maciejgaik/Inverted_pendulum/Latex/main.tex

%\documentclass[printmode,oneside,eng]{mgr}  % do publikacji elektronicznej
\documentclass[oneside,printmode,eng]{mgr}  % do wydruku dwustronnego
%\documentclass[printmode,eng,draft]{mgr}  % do wydruku dwustronnego w~wersji roboczej

%----------------------| Input encoding configuration |

\usepackage[utf8]{inputenc}

%-------------------------| Typeface configuration |------------------------

%% Najpierw (chyba) należy wybrać czcionkę tekstu, potem matematyki

%% wybór czcionki Computer Concrete specjalnie zaprojektowanej do użycia 
%% z~czcionką matematyczną euler (nie ma ona niestety wersji bold - proponuje się więc użycie bolda z kroju
%%   Computer Modern Sans Serif)
%\usepackage{beton}             % ZALECANA DO SKŁADU TEKSTÓW PO ANGIELSKU
%\renewcommand{\bfdefault}{sbc} % to use Computer Modern Sans Serif demibold condensed fonts as bold 
%% choć może komuś bardziej podobać się będzie ten krój normalnej szerokości
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
  \begin{minipage}{\linewidth-2\fboxsep}}
 {\end{minipage}%
  \end{lrbox}%
  \setlength{\topsep}{\bigskipamount}% set the vertical space
  \trivlist\item\relax % ensure going to a new line
  \colorbox{\minted@bgcol}{\usebox{\minted@bgbox}}%
  \endtrivlist % close the trivlist
 }
\makeatother

%%pakiet do robienia notatek w trakcie pracy
\usepackage{todonotes}
\makeatletter   %spolszczenie
\renewcommand{\@todonotes@todolistname}{Do zrobienia}
\renewcommand{\@todonotes@MissingFigureText}{Rysunek}
\renewcommand{\@todonotes@MissingFigureUp}{Brakujący}
\renewcommand{\@todonotes@MissingFigureDown}{rysunek}
\makeatother

%% dodaje w pliku wynikowym klucze etykiet i referencji - wygodne przy pracy nad tekstem
%\usepackage{showkeys}

%%inne przydatne
%\usepackage{fancyhdr}
%\usepackage{fancyvrb}
%\usepackage{lipsum}  
%\usepackage{listings}

%-----------------------| End of packetology |----------------------

%---------------------------| Tytularia |---------------------------

% Zmień dane stosownie do tytułu i autora pracy tutaj
% ALE TEŻ I W POLECENIU \pdftitle NIECO PONIŻEJ! (Hyper data general configuration)
\author{Maciej Gaik}
\title{Projekt budowy odwróconego wahadła matematycznego}
\engtitle{Design and construction reversed pendulum}
\supervisor{Dr inż. Mateusz Cholewiński,\\ Katedra Cybernetyki i~Robotyki}
\field{Automatyka i~Robotyka (AIR)}
\specialisation{Robotyka (ARR)}
\date{2020}

%-------------------------| Hyper data general configuration |------------------------

\hypersetup{unicode,
   pdfpagemode=UseOutlines,   % otwiera dokument w trybie jednej strony
   pdfpagelayout=SinglePage,  %
   pdfstartpage=1,            % na podanej stronie
   bookmarksopen=true,        % rozwinięcie zakładek
   bookmarksopenlevel=1,      % do jakiego poziomu
   colorlinks=true,      % kolorowanie odnośników zamiast ramki wokół nich
   citecolor=cyan,       % kolor odnośników do bibliografii, domyślnie zielony
   filecolor=red,        % kolor odnośników do lokalnych plików, domyśnie magenta
   linkcolor=blue,       % kolor odnośników wewnętrznych, domyślnie czerwony
   menucolor=green,      % kolor pozycji menu Acrobata, domyślnie czerwony
   urlcolor=blue,        % kolor odnośników do adresów internetowych, domyślnie cyan
                              % DANE DOKUMENTACJI
   pdftitle={Bąk jaki jest każdy widzi. Studium zachowań - Przykład
    i~wytyczne formatowania pracy dyplomowej},
   pdfauthor={Roberto Orozco, Robert Muszyński},
   pdfsubject={Praca dyplomowa inżynierska - przykład i~wytyczne},
   pdfkeywords={bąk, Lagrange top, Euler top, praca dyplomowa, formatowanie, wytyczne}
}

%-------------------------| Geometria strony |-----------------------------

\geometry{
    top = 25mm,
    headheight = 15mm,
    headsep = 3mm,
    textheight = 24cm,
    textwidth = 16cm,
}

%---------------------| Frequently used commands definitions |-------------------

\newcommand{\red}{\color{red}}
\def\BibTeX{{\rm B\kern-.05em{\sc i\kern-.025em b}\kern-.08em
    T\kern-.1667em\lower.7ex\hbox{E}\kern-.125emX}}

\newtheorem{uwaga}{Uwaga}
\newtheorem{twr}{Twierdzenie}
%------------------------------------| END |-------------------------------------

%----------------------------| Math symbols definition |-------------------------

\newcommand{\angmom}{\boldsymbol{m}}
\newcommand{\bdvelo}{\boldsymbol{\omega}_B}
\newcommand{\grav}{\boldsymbol{g}}
\newcommand{\lagran}{L(\boldsymbol{q},\boldsymbol{\dot{q}})}
\newcommand{\COMvec}{\boldsymbol{r}_B}
\newcommand{\ee}{\boldsymbol{e}}
\newcommand{\FF}{\boldsymbol{F}}
\newcommand{\xx}{\boldsymbol{x}}
\newcommand{\qq}{\boldsymbol{q}}
\newcommand{\RR}{\boldsymbol{R}}
\newcommand{\TT}{\boldsymbol{T}}
\newcommand{\pp}{\boldsymbol{p}}
\newcommand{\iner}{\boldsymbol{I}_B}
\newcommand{\vv}{\boldsymbol{v}}
\newcommand{\bbs}{\boldsymbol}
\DeclareMathOperator{\const}{const}
\DeclareMathOperator*{\rank}{rank} 

\graphicspath{{figures/chapter_01/}{figures/chapter_02/}{figures/chapter_03/}{figures/chapter_04/}}

\begin{document}

\pdfbookmark{Strona tytułowa}{tytul}
\maketitle
%% informacja o sposobie udostępniania tego dokumentu
%\input{sources/copyleft.tex}

\cleardoublepage
\pdfbookmark{\contentsname}{Contents}
\tableofcontents            %spis treści
\markboth{\contentsname}{\contentsname}
%\input{sources/notka}       %notka o systemie składu i czcionkach
%\input{sources/font-note}   %przykładowa wersja angielska notki

%% część właściwa dokumentu
\include{praca_dyplomowa/sources/00_Wstep}
\include{praca_dyplomowa/sources/01_wprowadzenie_matematyczne}
\include{praca_dyplomowa/sources/02_symulacja}
\include{praca_dyplomowa/sources/03_konstrukcja}
\include{praca_dyplomowa/sources/04_elektronika}
\include{praca_dyplomowa/sources/05_oprogramowanie}
\include{praca_dyplomowa/sources/06_sterowanie}
\include{praca_dyplomowa/sources/50_zakonczenie}

\cleardoublepage
\phantomsection
\addcontentsline{toc}{chapter}{\bibname}
\bibliographystyle{alphapl}
\bibliography{sources/bibliografia}
\markboth{\bibname}{\bibname}

%%spis rysunków
\cleardoublepage
\phantomsection
\addcontentsline{toc}{chapter}{\listfigurename}
\listoffigures
\markboth{\listfigurename}{\listfigurename}

\appendix
\include{sources/90_dodatek_a}

\end{document}
