maciejgaik/Inverted_pendulum/Latex/sources/90_dodatek_a.tex

%\chapter{Skrypt symulacji}
\begin{figure}[tp]
    \centering
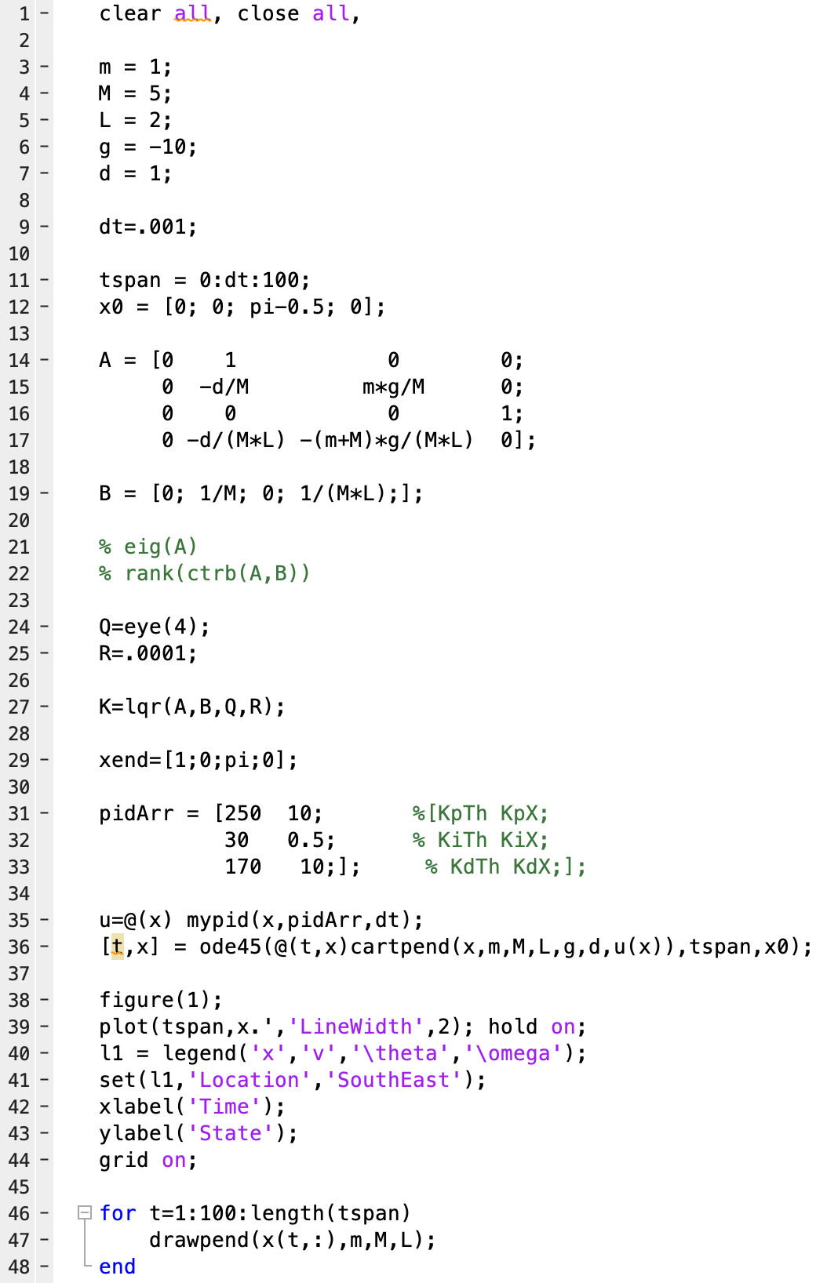
[picture p19: Latex/figures/simpend.png]
    
    \caption{Główny skrypt symulacji}
    \label{fig:simpend}
\end{figure}

\begin{figure}
    \centering
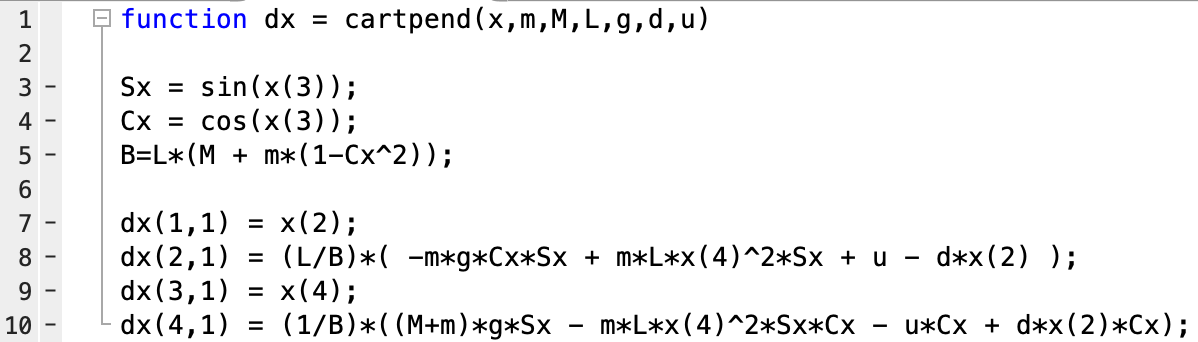
[picture p20: Latex/figures/cartpend.png]
    
    \caption{Funkcja \textit{cartpend}}
    \label{fig:cartpend}
\end{figure}

\begin{figure}
    \centering
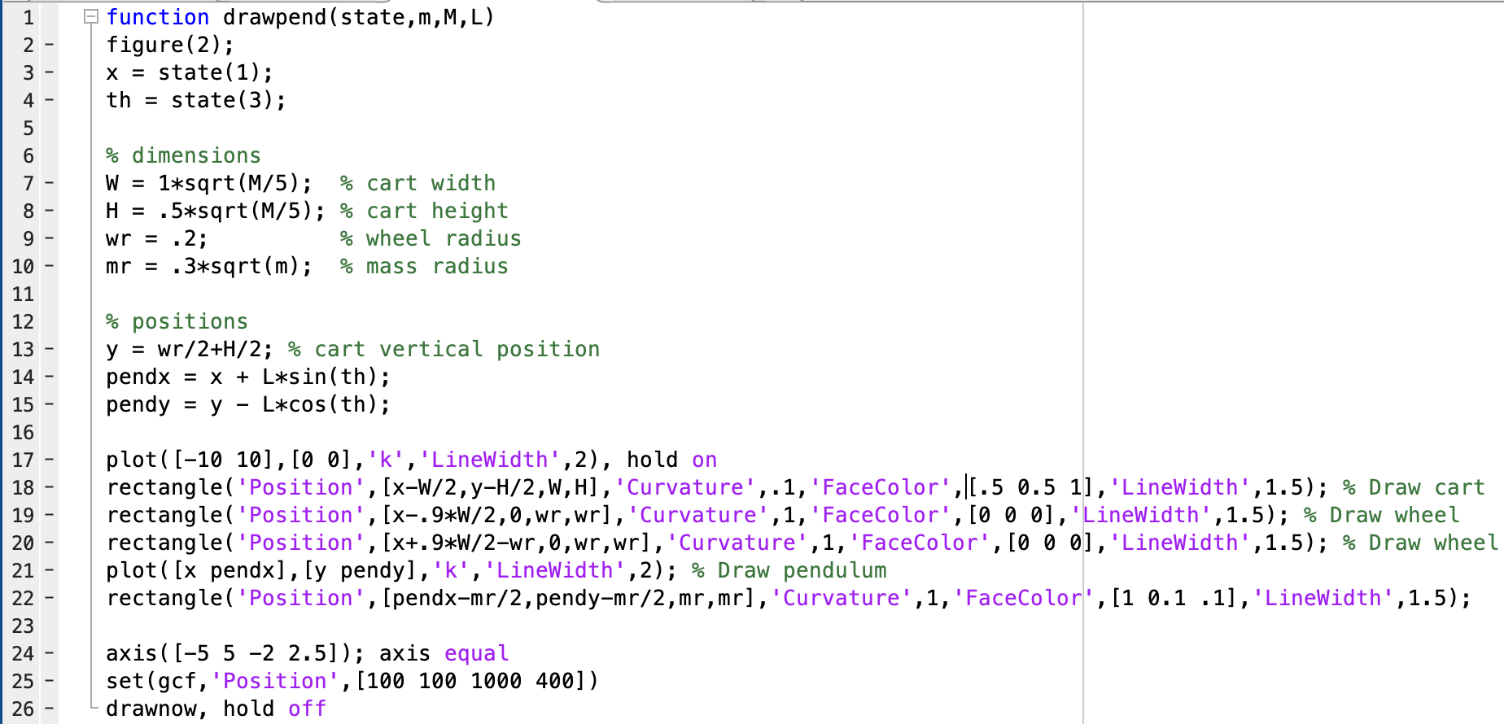
[picture p21: Latex/figures/drawpend.png]
    
    \caption{Funkcja \textit{drawpend}}
    \label{fig:drawpend}
\end{figure}

\begin{figure}
    \centering
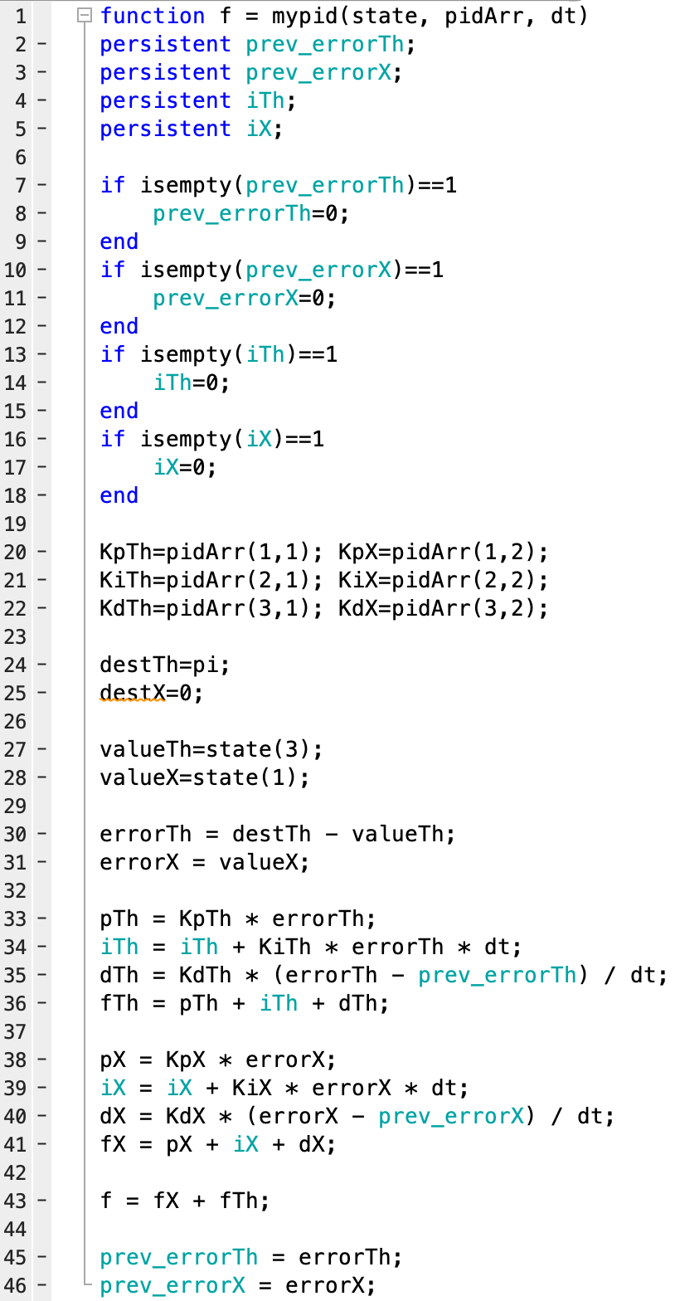
[picture p22: Latex/figures/mypid.png]
    
    \caption{Funkcja \textit{mypid}}
    \label{fig:mypid}
\end{figure}

%\chapter{Oprogramowanie}
\begin{figure}
    \centering
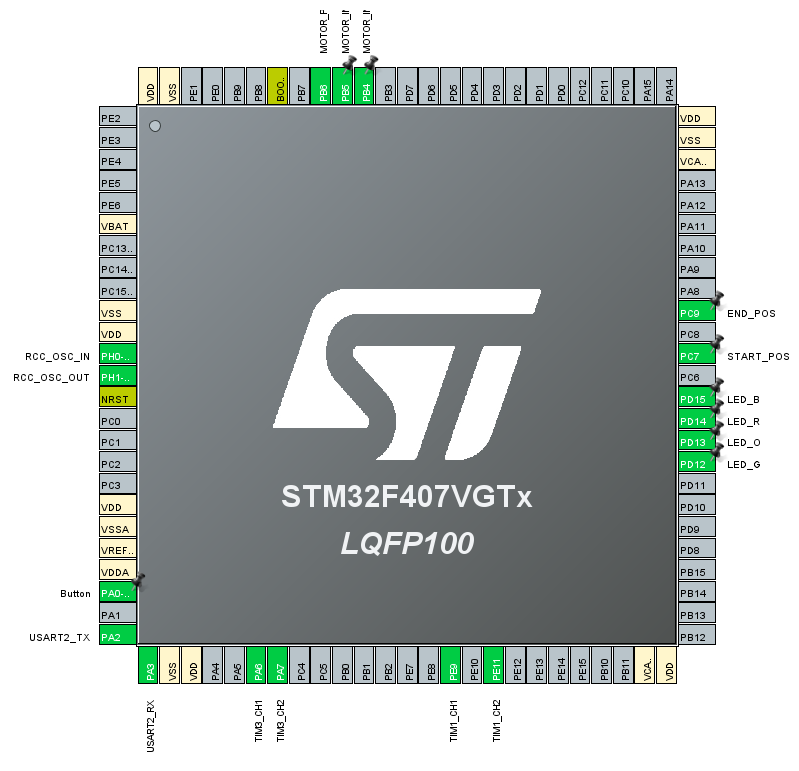
[picture p23: Latex/figures/stmConfig.png]
    
    \caption{Konfiguracja wejść/wyjść mikrokontrolera}
    \label{fig:stmconfig}
\end{figure}

\begin{figure}
    \centering
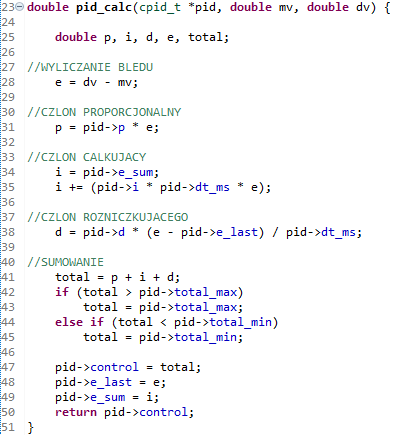
[picture p24: Latex/figures/pidkod.png]
    
    \caption{Algorytm regulatora \textit{PID IND}}
    \label{fig:pidind}
\end{figure}
