maciejgaik/Inverted_pendulum/Image/EnkderWah.png

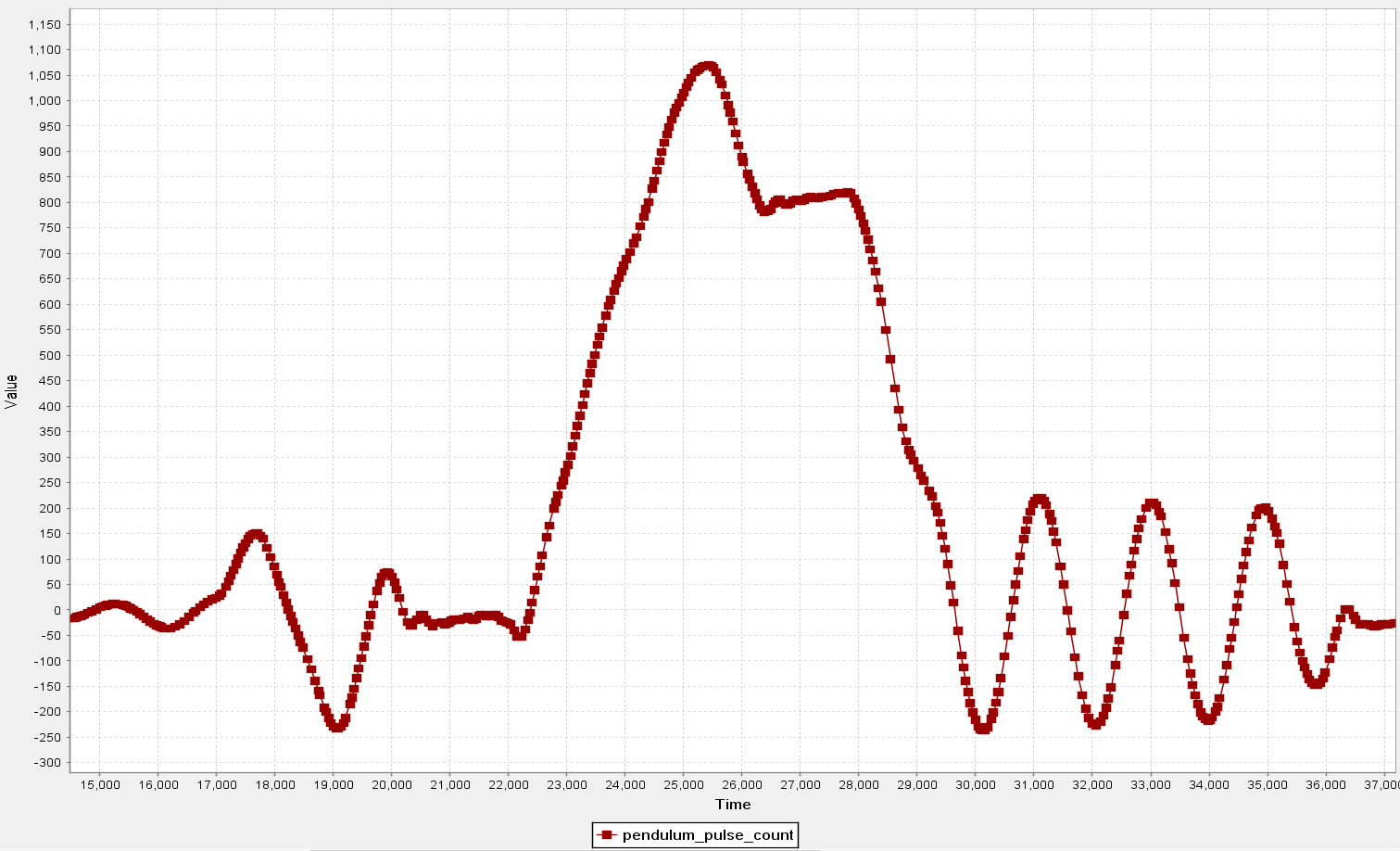
Image/EnkderWah.png
