maciejgaik/Inverted_pendulum/Image/IMG_20200908_130321.jpg

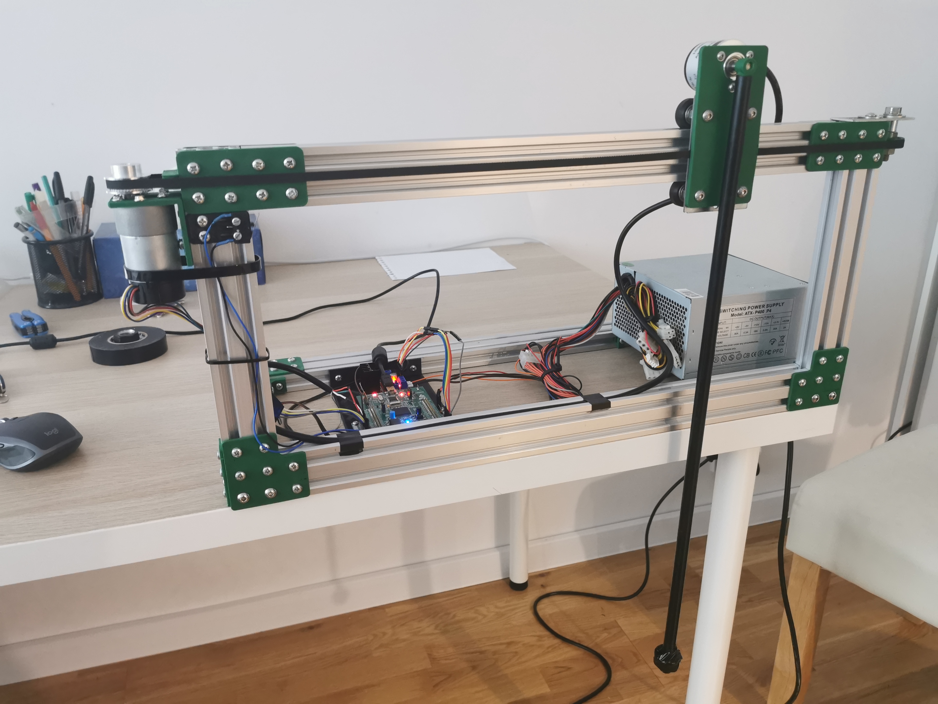
Image/IMG_20200908_130321.jpg
