maciejgaik/Inverted_pendulum/Image/IMG_20200908_130335.jpg

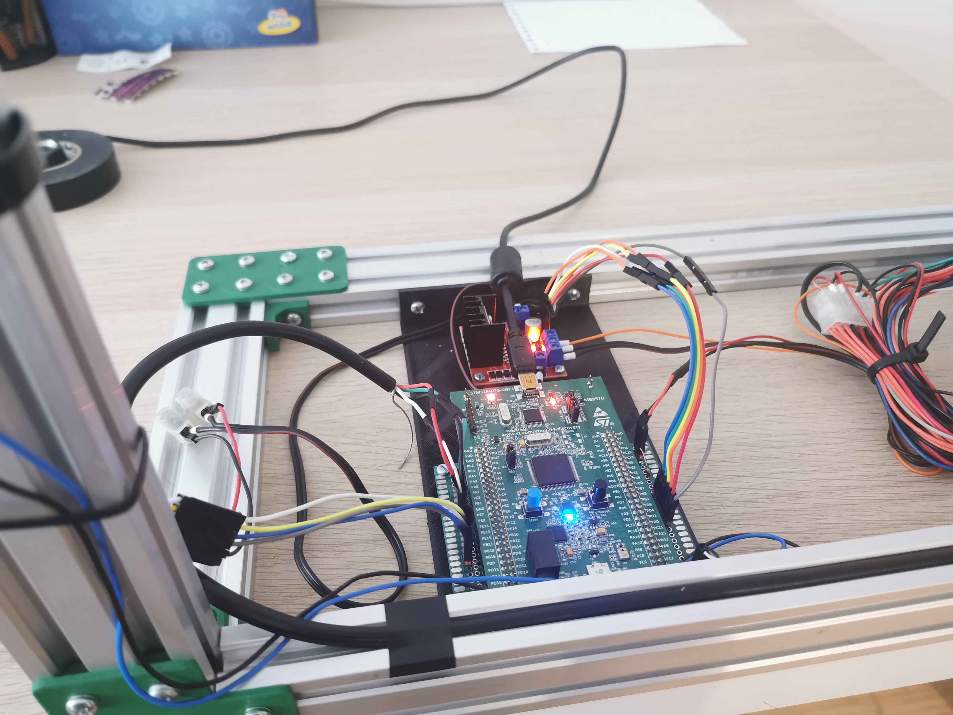
Image/IMG_20200908_130335.jpg
