maciejgaik/Inverted_pendulum/Image/IMG_20200908_130345.jpg

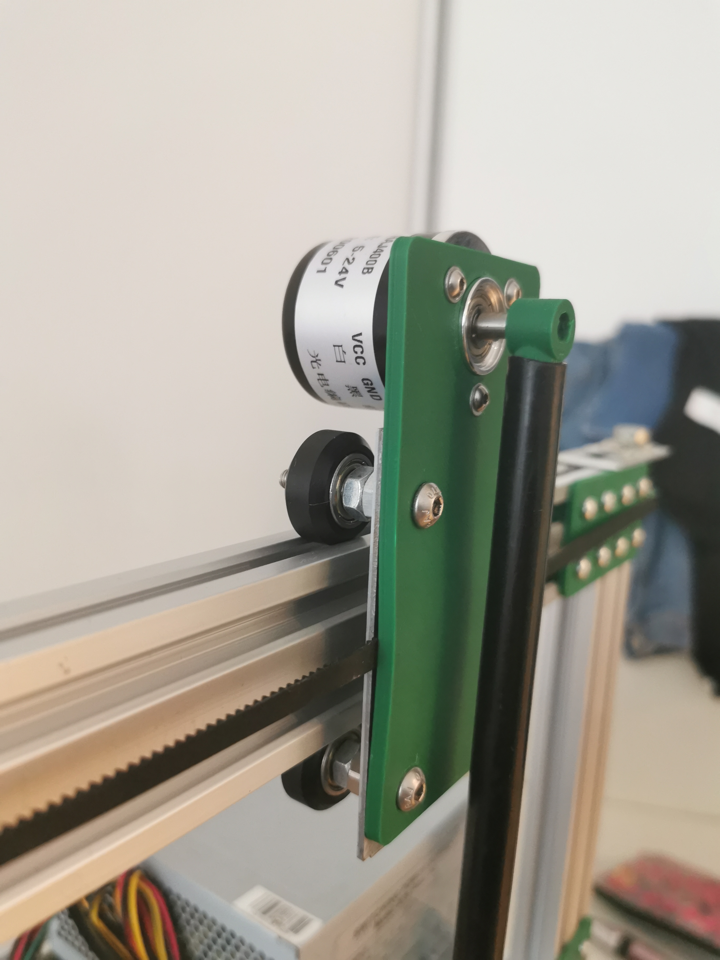
Image/IMG_20200908_130345.jpg
