maciejgaik/Inverted_pendulum/Image/pdmotor.png

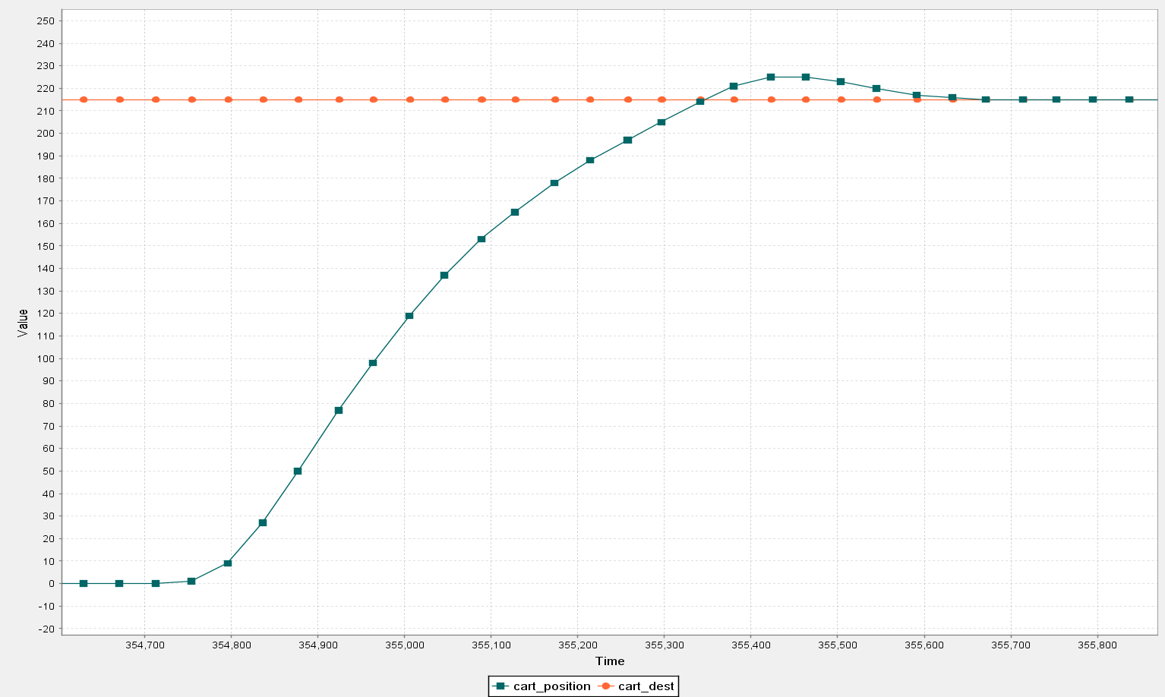
Image/pdmotor.png
