maciejgaik/Inverted_pendulum/Image/pendulum1.jpg

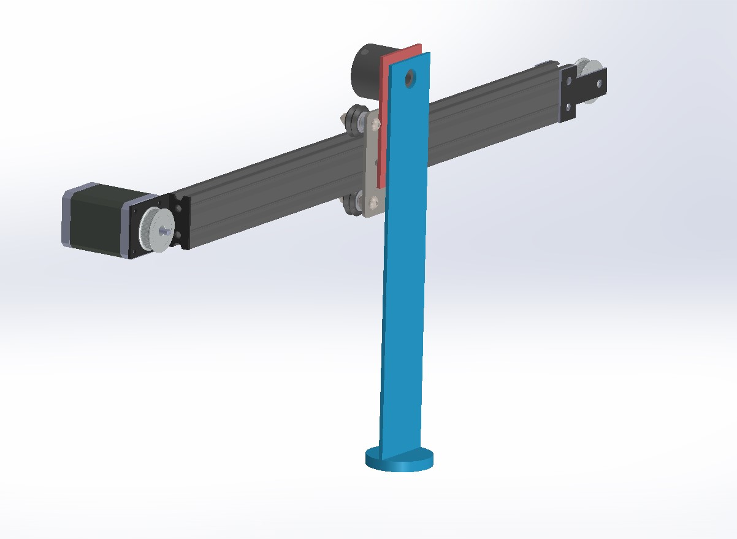
Image/pendulum1.jpg
