maciejgaik/Inverted_pendulum/Image/pendulum2.jpg

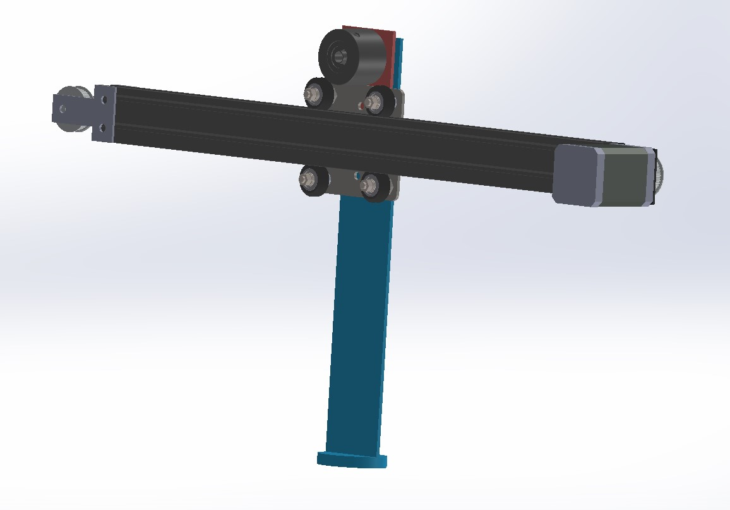
Image/pendulum2.jpg
