maciejgaik/Inverted_pendulum/Image/pendulum3.jpg

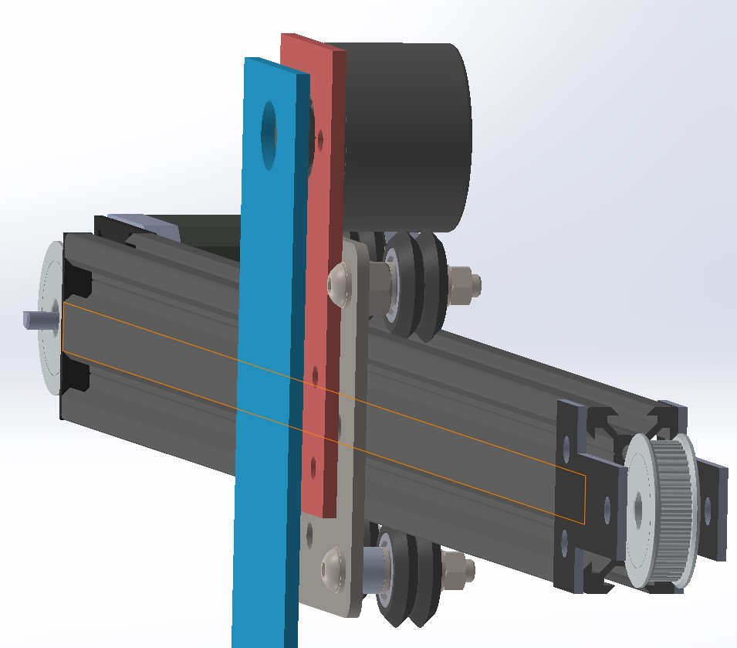
Image/pendulum3.jpg
