maciejgaik/Inverted_pendulum/Image/pendulum4.jpg

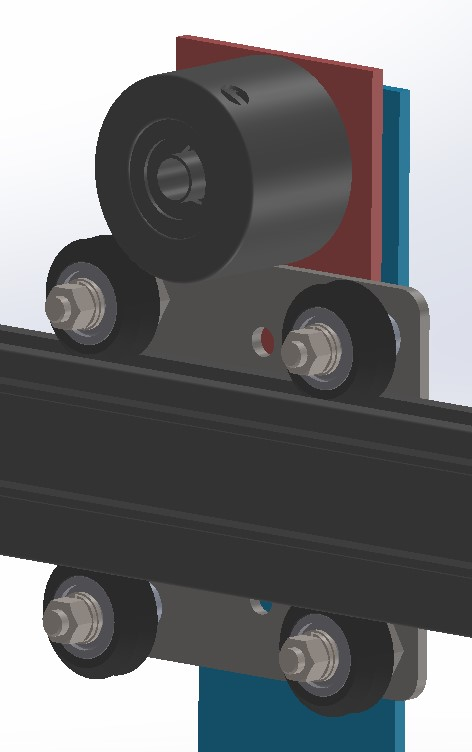
Image/pendulum4.jpg
