maciejgaik/Inverted_pendulum/Image/pendulum5.jpg

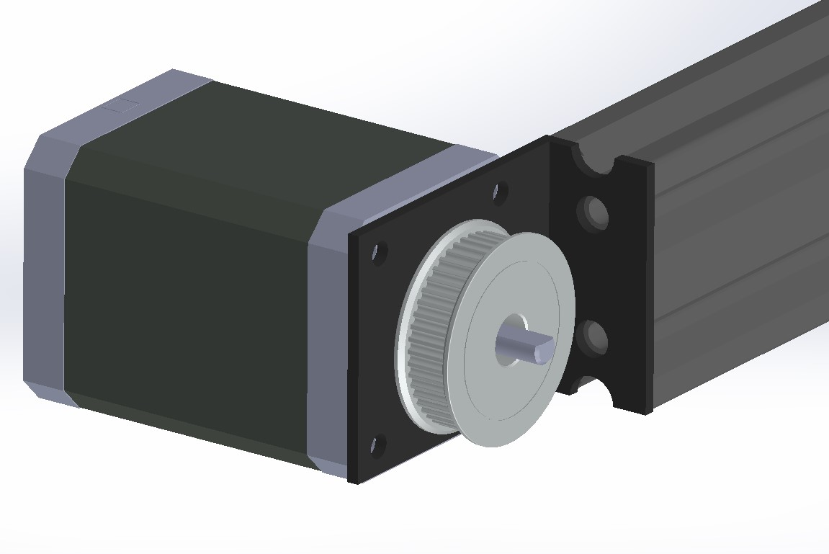
Image/pendulum5.jpg
