maciejgaik/Inverted_pendulum/Image/pendulum7.jpg

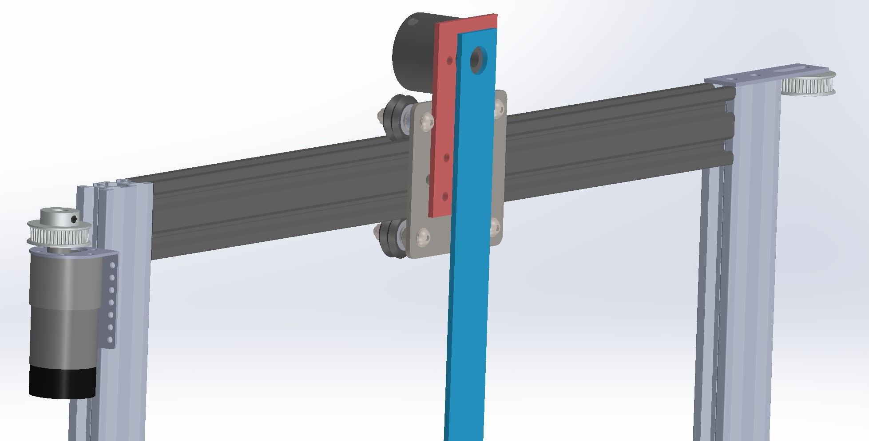
Image/pendulum7.jpg
