maciejgaik/Inverted_pendulum/Image/pidcontrol-alpha.png

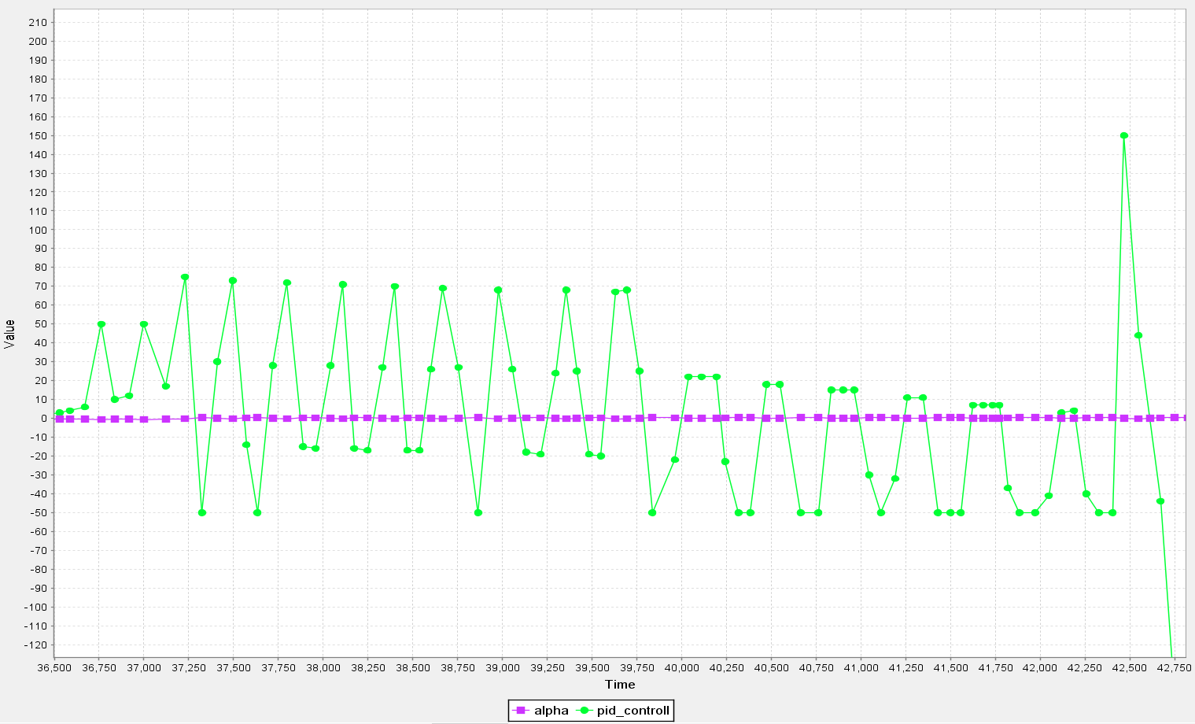
Image/pidcontrol-alpha.png
