maciejgaik/Inverted_pendulum/Image/pidpend.png

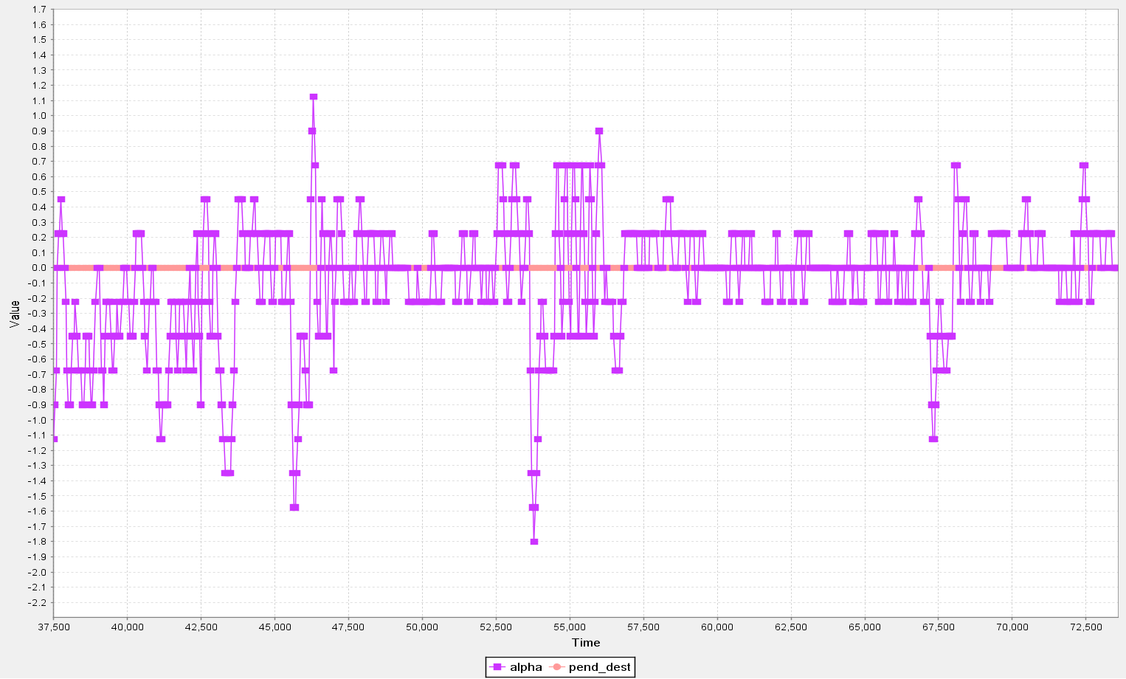
Image/pidpend.png
