maciejgaik/Inverted_pendulum/Latex/figures/EnkderWah.png

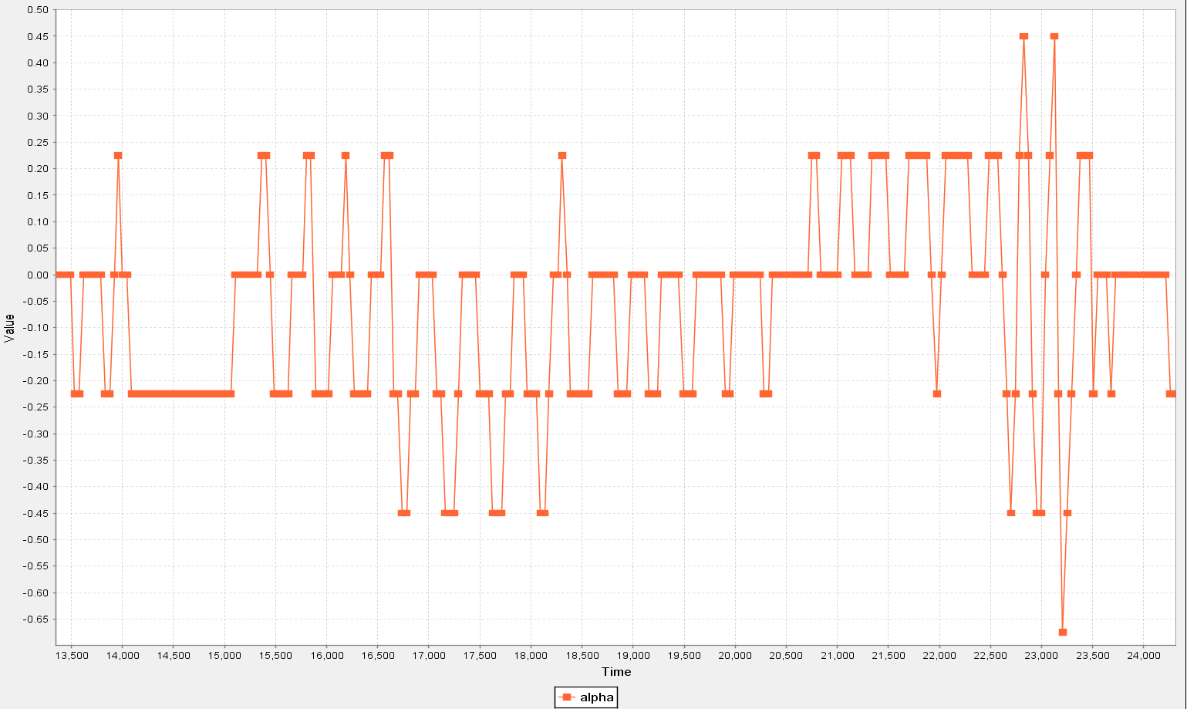
Latex/figures/EnkderWah.png
