maciejgaik/Inverted_pendulum/Latex/figures/EnkoderMot.png

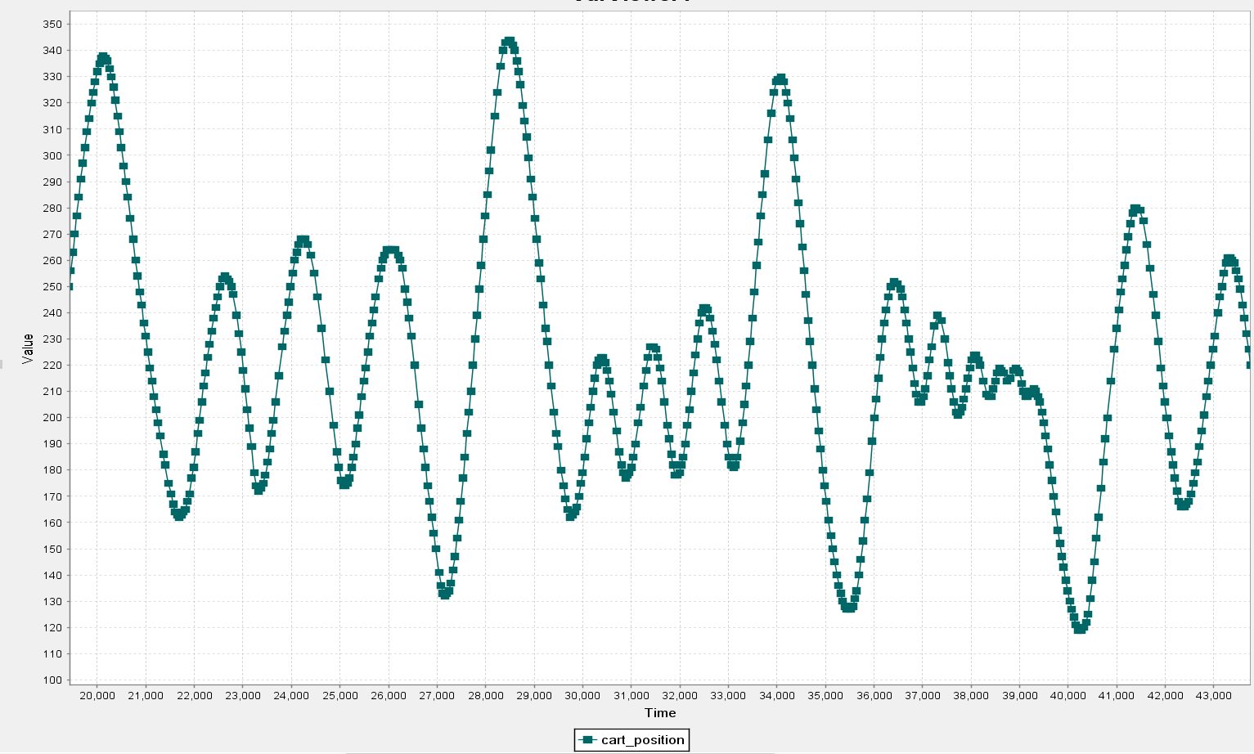
Latex/figures/EnkoderMot.png
