maciejgaik/Inverted_pendulum/Latex/figures/pendulum6.jpg

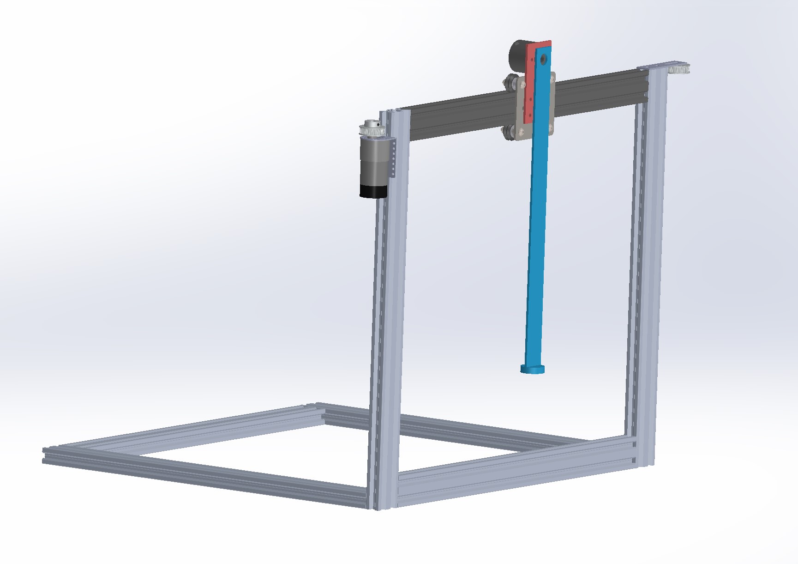
Latex/figures/pendulum6.jpg
