maciejgaik/Inverted_pendulum/Latex/figures/rpidisplay2.jpg

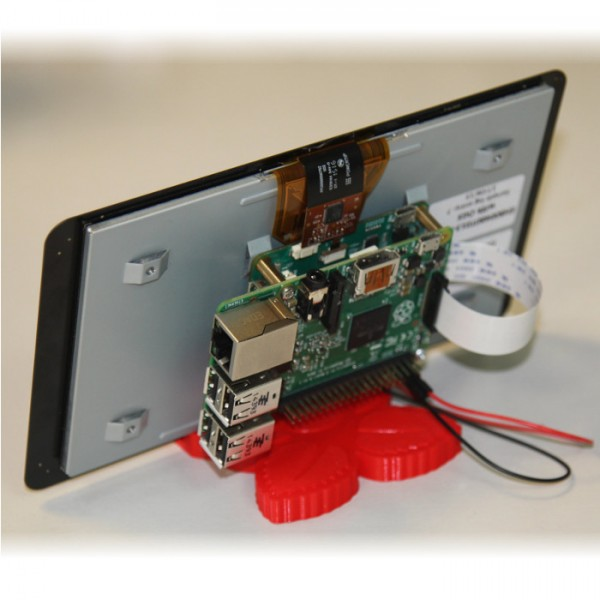
Latex/figures/rpidisplay2.jpg
