maciejgaik/Inverted_pendulum/Latex/figures/WykresEnkoder.png

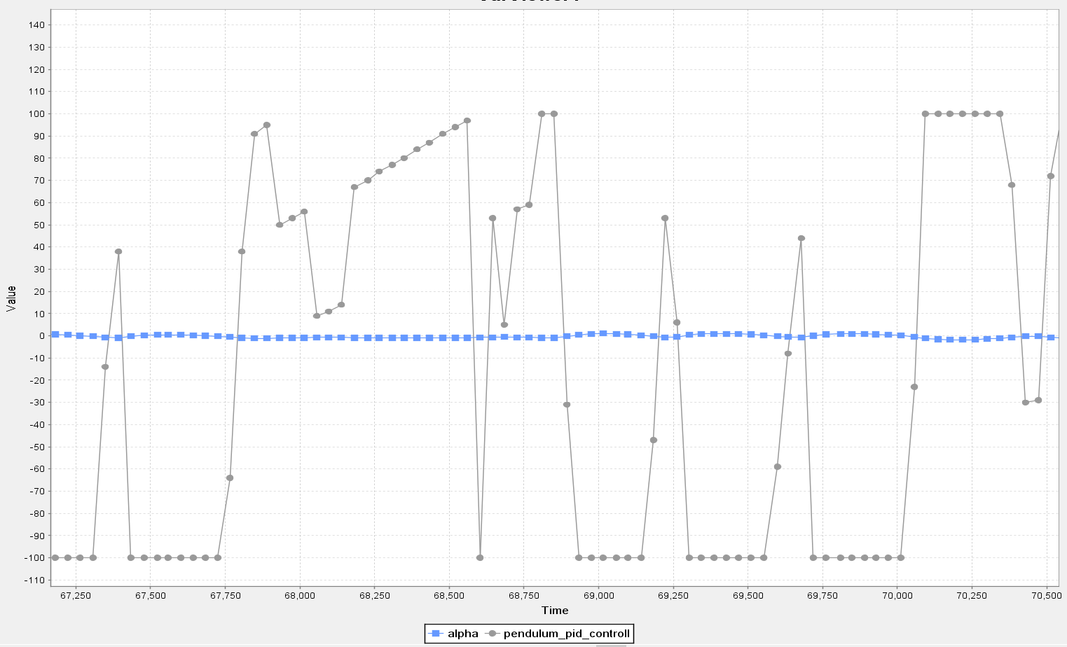
Latex/figures/WykresEnkoder.png
