maciejgaik/Inverted_pendulum/Latex/figures/WykresMain.png

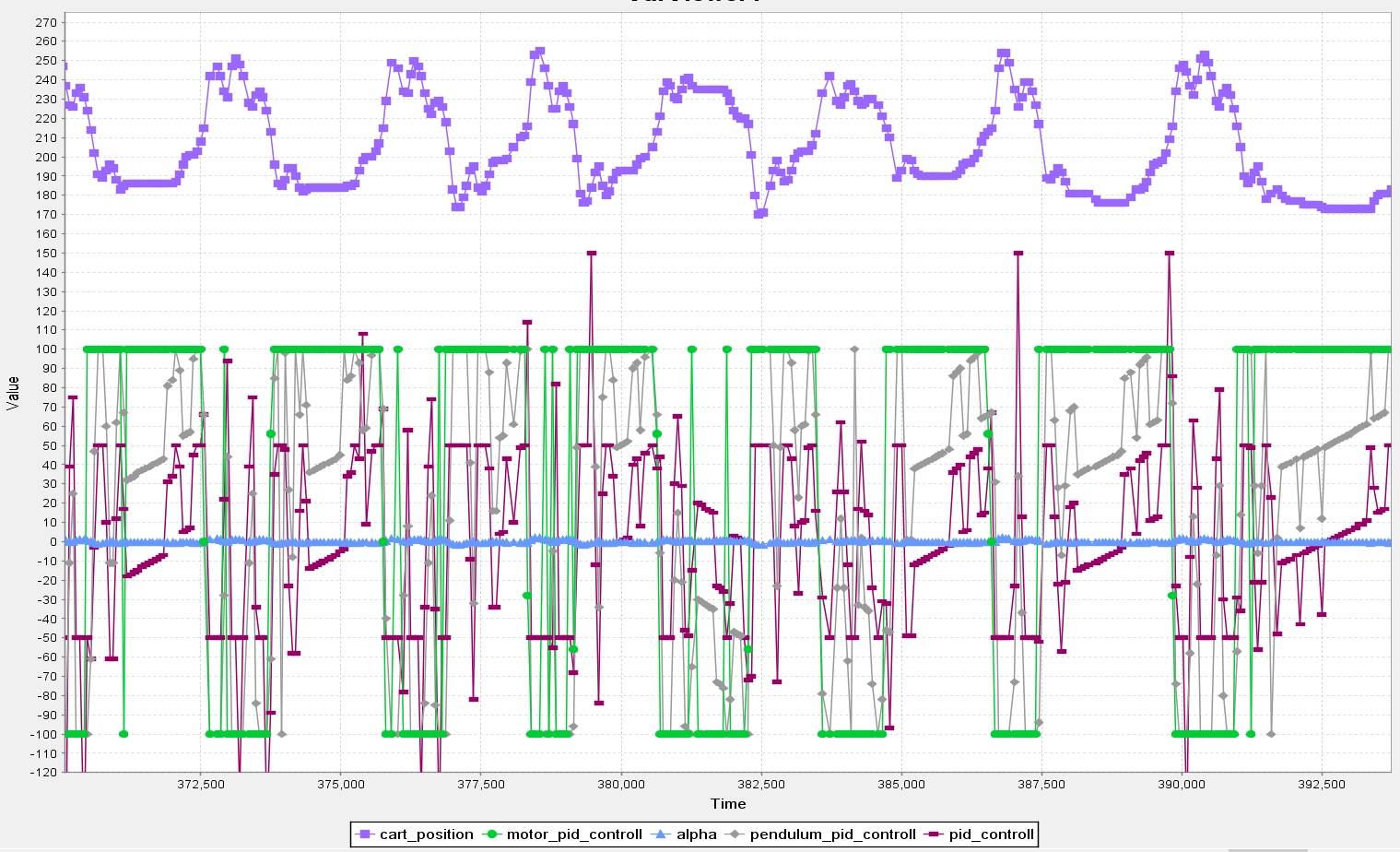
Latex/figures/WykresMain.png
