maciejgaik/Inverted_pendulum/Latex/figures/WykresMotor.png

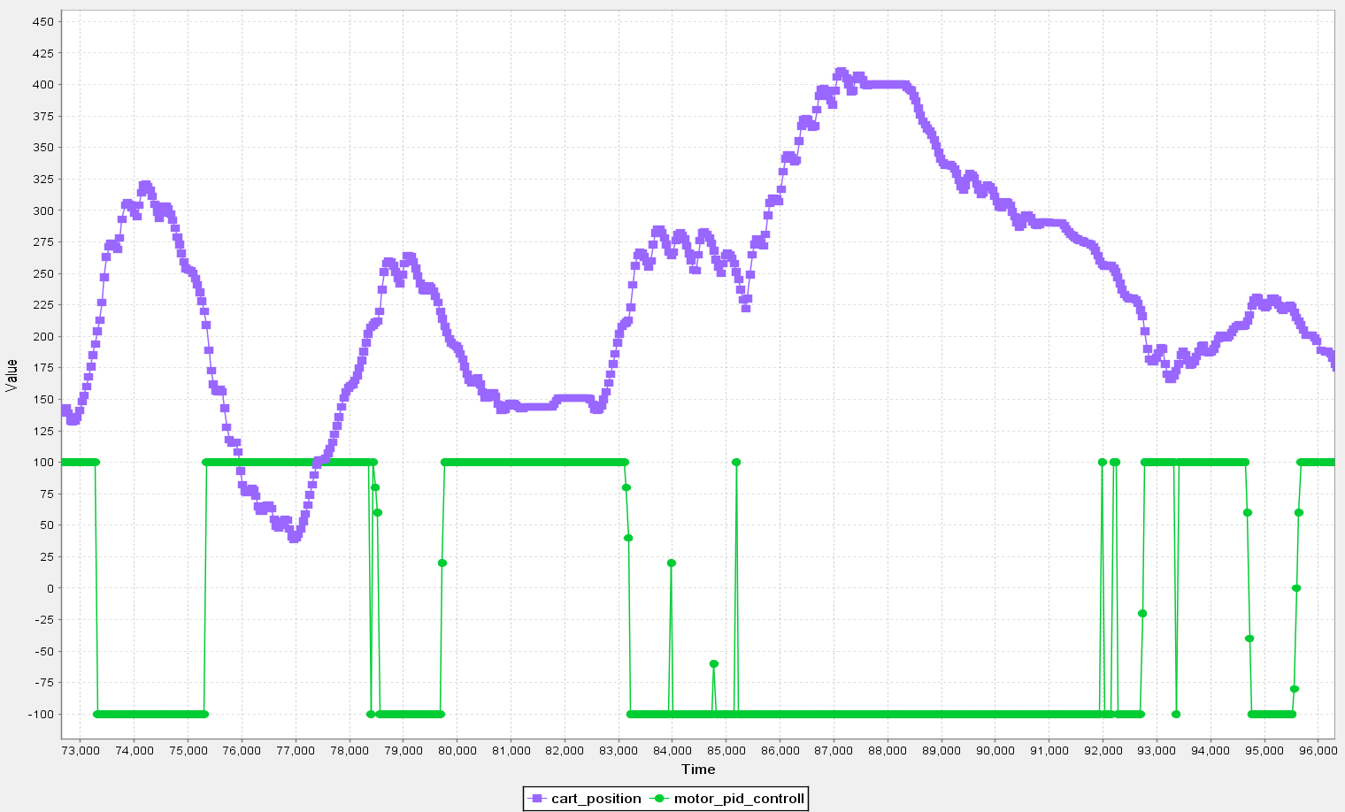
Latex/figures/WykresMotor.png
