maciejgaik/Inverted_pendulum/Assembling/Złożenie3.SLDASM

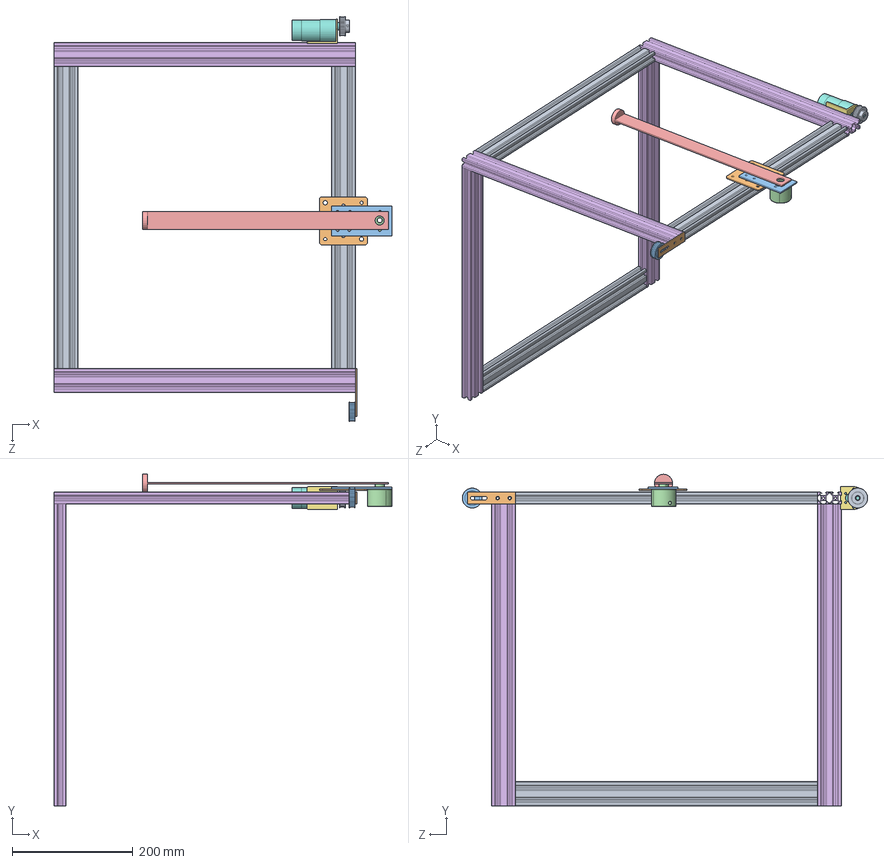
[picture p47: CAD file, 2020-08-21]
Assembling/Złożenie3.SLDASM
560.2 x 549.6 x 671.9 mm
profil 2040 500 x 3
Kit CGV02-05 + EEV01-01 + RWV01-01
bracket
Encoder tanso H40
pendulum
profil 2040 250 x 4
Pololu Stamped Aluminum L-Bracket Pair for 37D mm Metal Gearmotors
Gearmotor_37D_100.stp
GT2_48T_8_6
idle bracket
GT2_48T_8_6 idle
