maciejgaik/Inverted_pendulum/Assembling/Encoder Bracket.SLDPRT

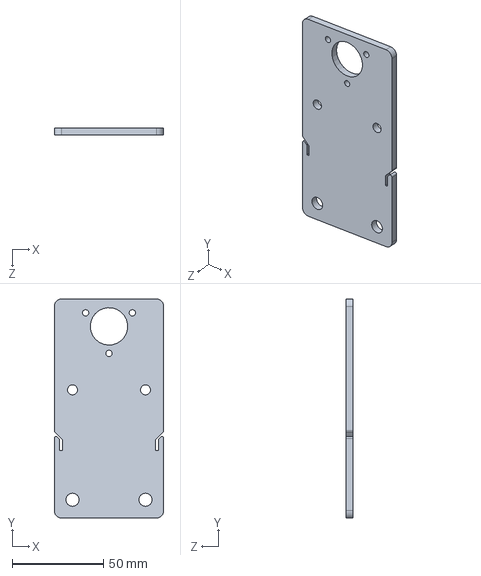
[picture p48: CAD file, 2020-09-28]
Assembling/Encoder Bracket.SLDPRT
60.0 x 120.0 x 4.00 mm
