maciejgaik/Inverted_pendulum/Assembling/krancowka2.SLDPRT

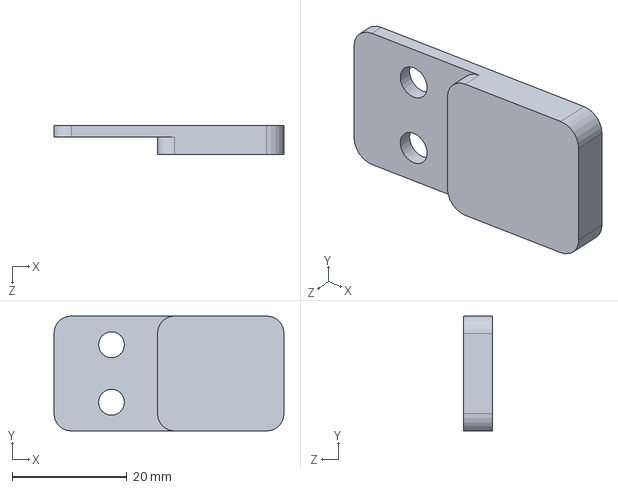
[picture p49: CAD file, 2020-09-01]
Assembling/krancowka2.SLDPRT
40.0 x 20.0 x 5.00 mm
