maciejgaik/Inverted_pendulum/Assembling/krancowka.SLDPRT

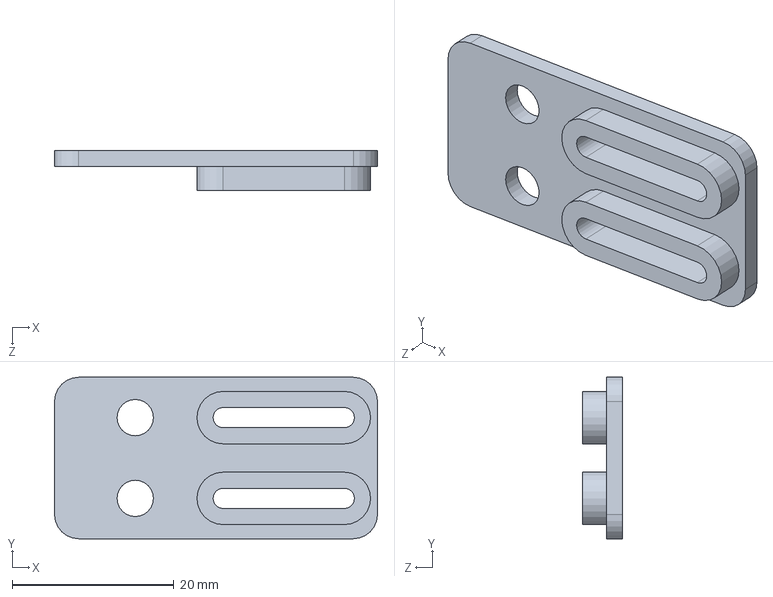
[picture p50: CAD file, 2020-09-01]
Assembling/krancowka.SLDPRT
40.0 x 20.0 x 5.00 mm
