maciejgaik/Inverted_pendulum/Assembling/stm bracket.STL

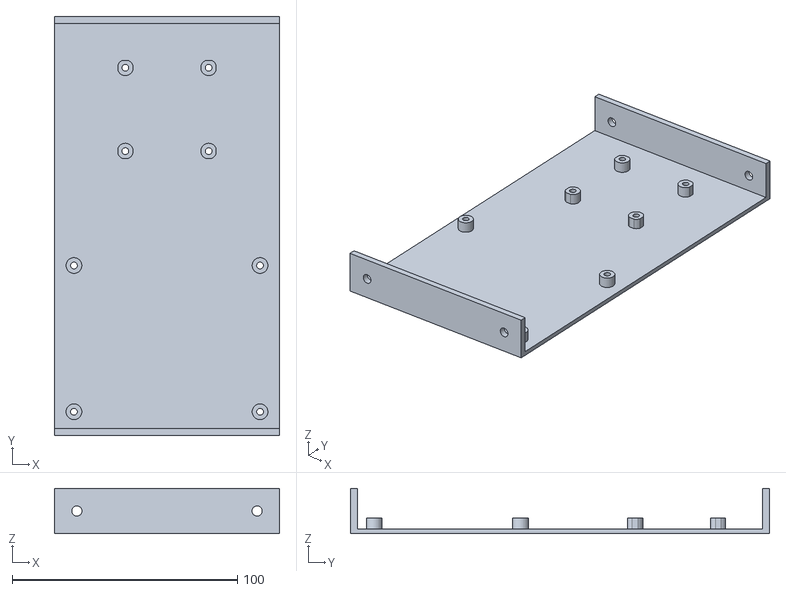
[picture p51: CAD file, 2020-08-29]
Assembling/stm bracket.STL
100.0 x 186.0 x 20.0
