maciejgaik/Inverted_pendulum/Assembling/power supply stand.SLDPRT

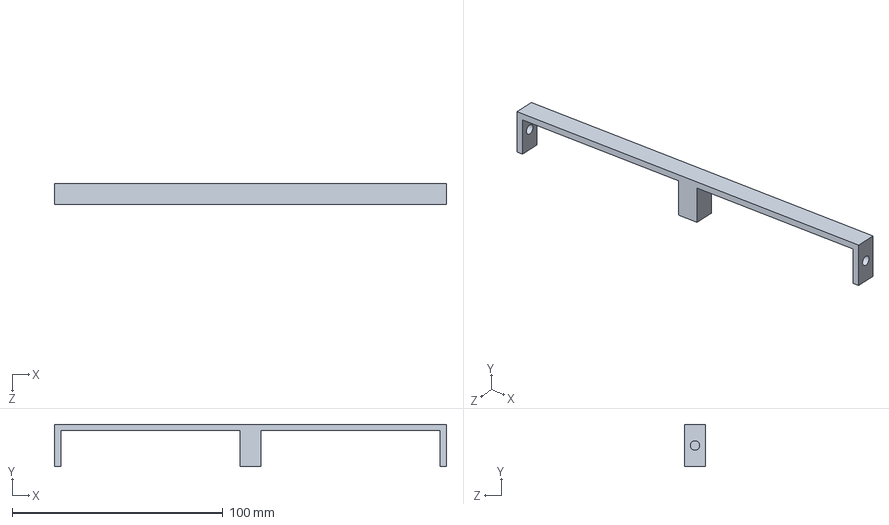
[picture p52: CAD file, 2020-08-27]
Assembling/power supply stand.SLDPRT
186.0 x 20.0 x 10.0 mm
