maciejgaik/Inverted_pendulum/Assembling/power supply bracket.SLDPRT

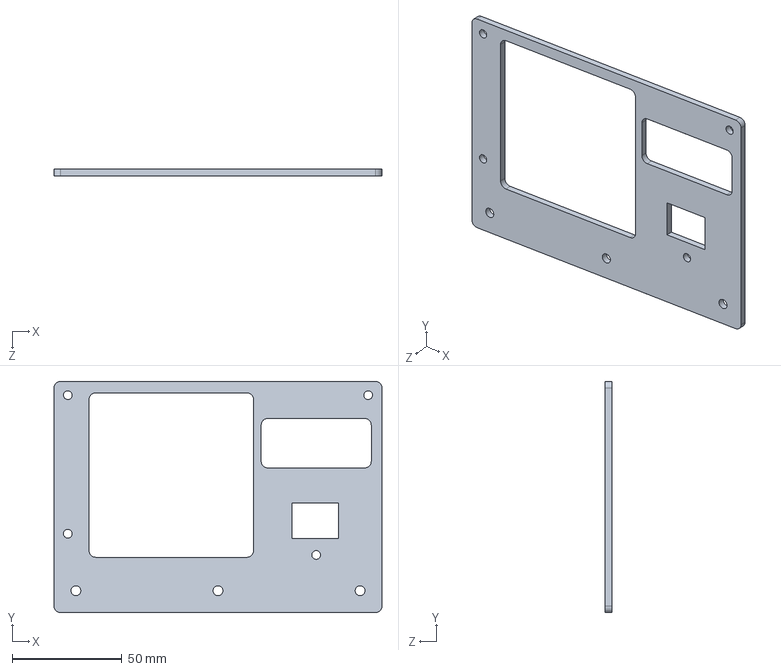
[picture p53: CAD file, 2020-08-27]
Assembling/power supply bracket.SLDPRT
149.6 x 105.5 x 3.00 mm
