maciejgaik/Inverted_pendulum/Assembling/pololu bracket.STL

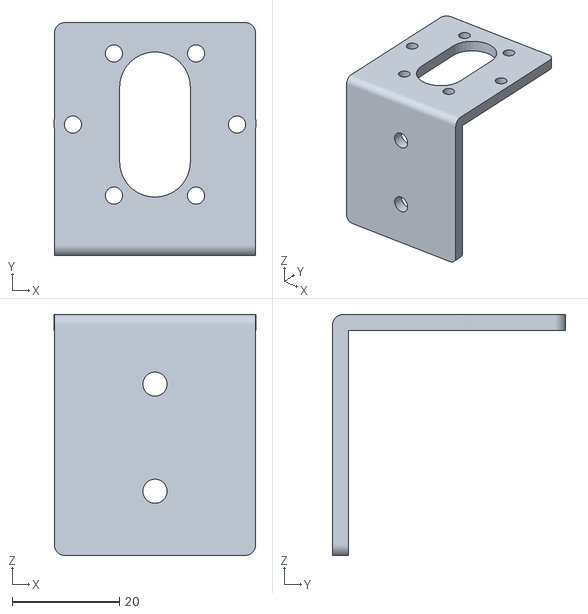
[picture p54: CAD file, 2020-08-27]
Assembling/pololu bracket.STL
37.7 x 43.5 x 45.0
