maciejgaik/Inverted_pendulum/Assembling/Pololu Stamped Aluminum L-Bracket Pair for 37D mm Metal Gearmotors.SLDPRT

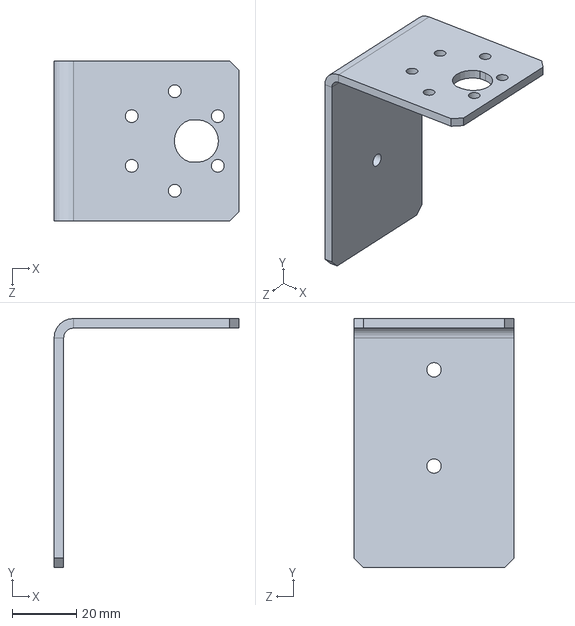
[picture p55: CAD file, 2020-08-27]
Assembling/Pololu Stamped Aluminum L-Bracket Pair for 37D mm Metal Gearmotors.SLDPRT
57.6 x 77.6 x 50.0 mm
