maciejgaik/Inverted_pendulum/Assembling/Kit CGV02-05 + EEV01-01 + RWV01-01.SLDPRT

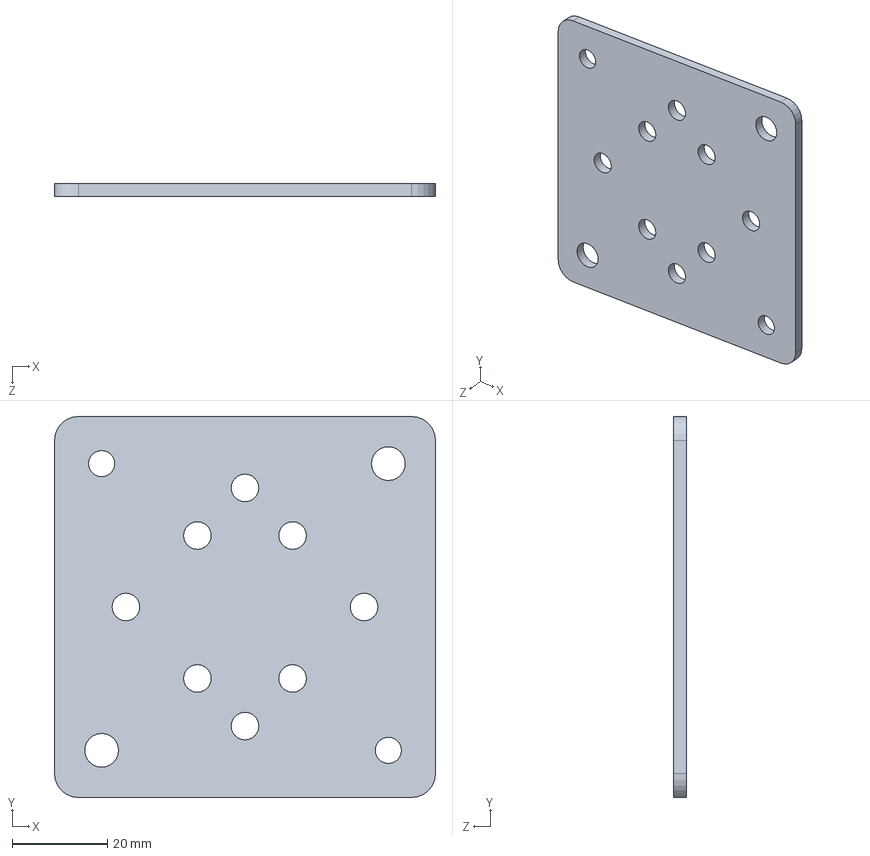
[picture p56: CAD file, 2020-08-21]
Assembling/Kit CGV02-05 + EEV01-01 + RWV01-01.SLDPRT
80.0 x 80.0 x 2.65 mm
