maciejgaik/Inverted_pendulum/Assembling/3x3 L Bracket.SLDPRT

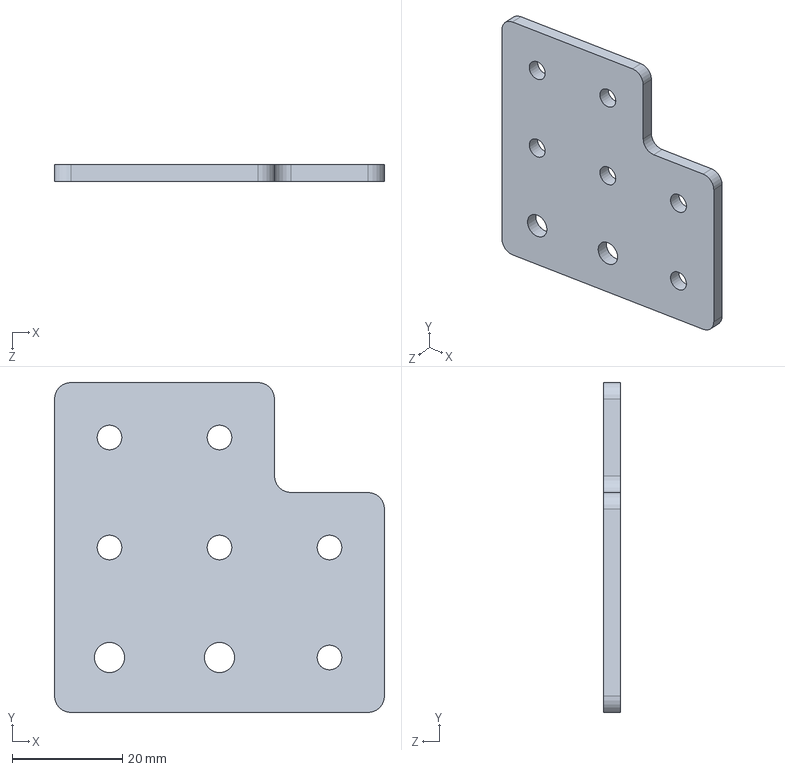
[picture p57: CAD file, 2020-08-19]
Assembling/3x3 L Bracket.SLDPRT
60.0 x 60.0 x 3.00 mm
