maciejgaik/Inverted_pendulum/Assembling/2x4_bracket.SLDPRT

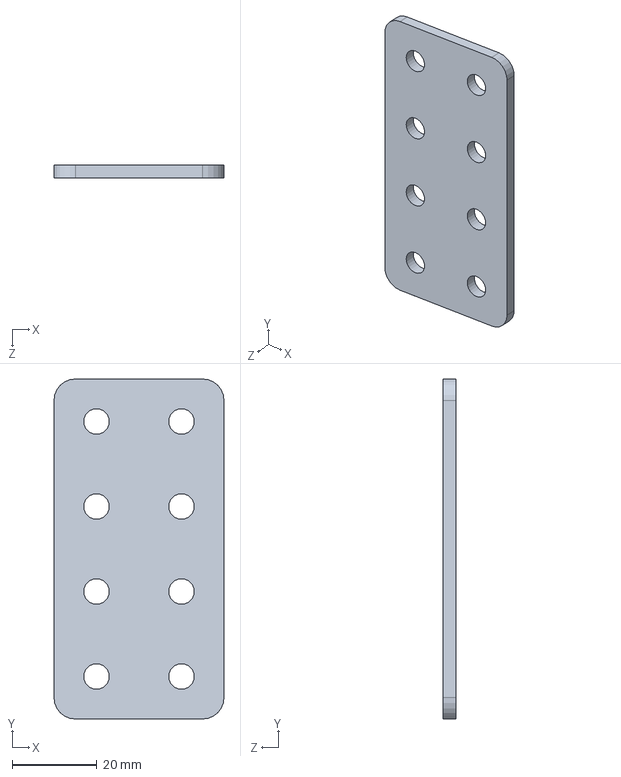
[picture p58: CAD file, 2020-08-17]
Assembling/2x4_bracket.SLDPRT
40.0 x 80.0 x 3.00 mm
