maciejgaik/Inverted_pendulum/Assembling/GT2_48T_8_6 idle.SLDPRT

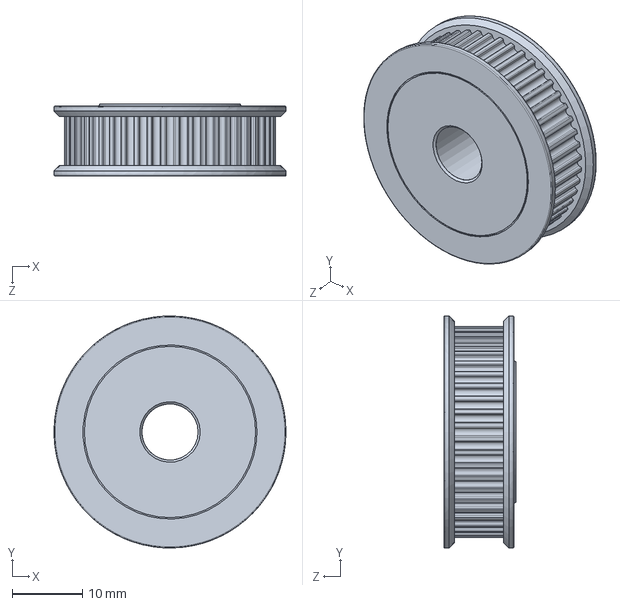
[picture p59: CAD file, 2020-08-15]
Assembling/GT2_48T_8_6 idle.SLDPRT
33.0 x 33.0 x 10.3 mm
