maciejgaik/Inverted_pendulum/Assembling/idle bracket.SLDPRT

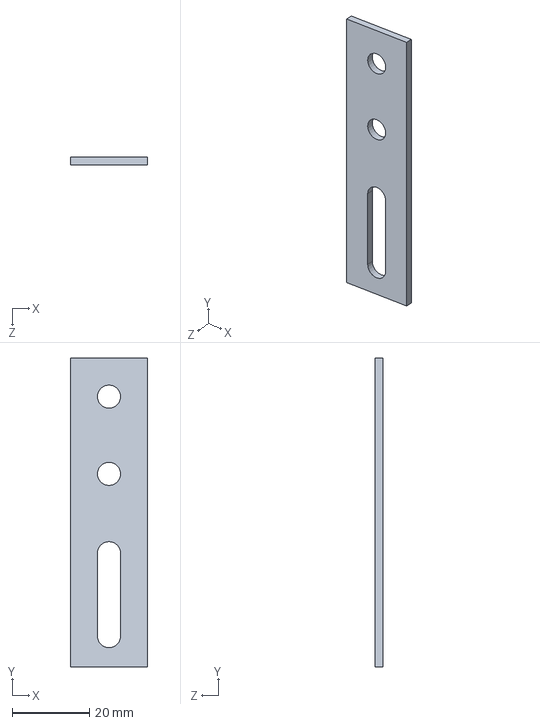
[picture p60: CAD file, 2020-08-15]
Assembling/idle bracket.SLDPRT
20.0 x 80.0 x 2.00 mm
