maciejgaik/Inverted_pendulum/Assembling/bracket.SLDPRT

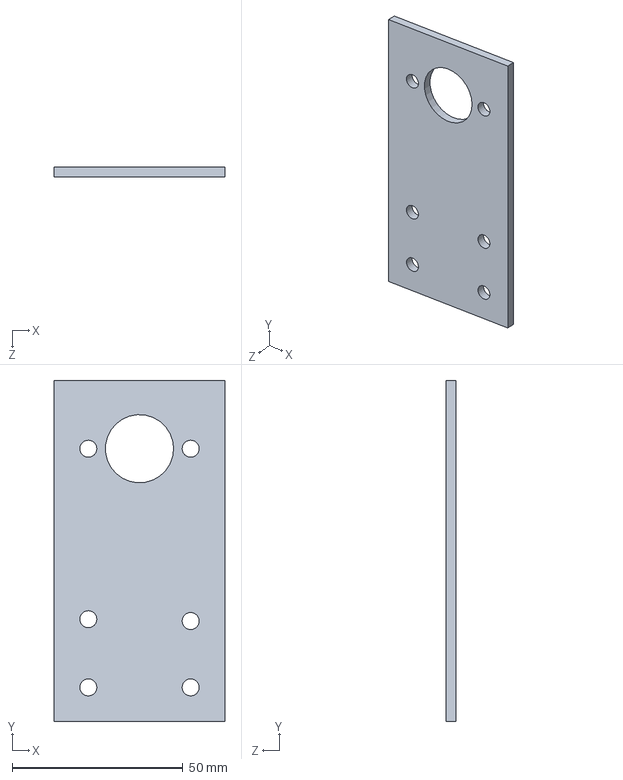
[picture p61: CAD file, 2020-08-15]
Assembling/bracket.SLDPRT
50.0 x 100.0 x 3.00 mm
