maciejgaik/Inverted_pendulum/Assembling/profil 2040 500.SLDPRT

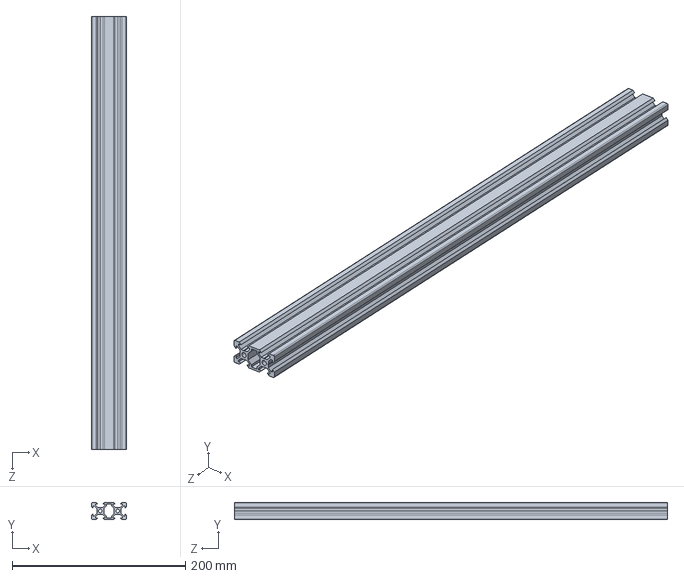
[picture p62: CAD file, 2020-08-15]
Assembling/profil 2040 500.SLDPRT
40.0 x 20.0 x 500.0 mm
