maciejgaik/Inverted_pendulum/Assembling/pendulum.SLDPRT

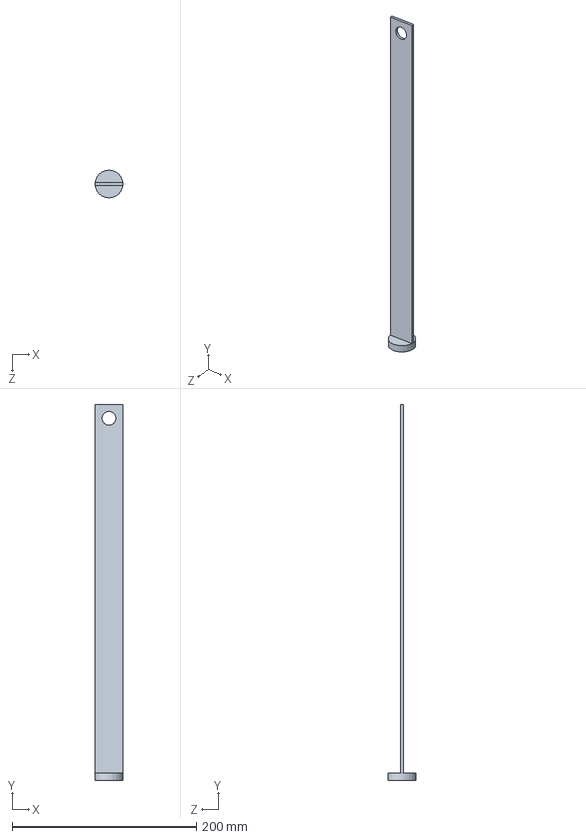
[picture p63: CAD file, 2020-08-15]
Assembling/pendulum.SLDPRT
30.1 x 408.0 x 30.1 mm
