maciejgaik/Inverted_pendulum/Assembling/TBracket.SLDPRT

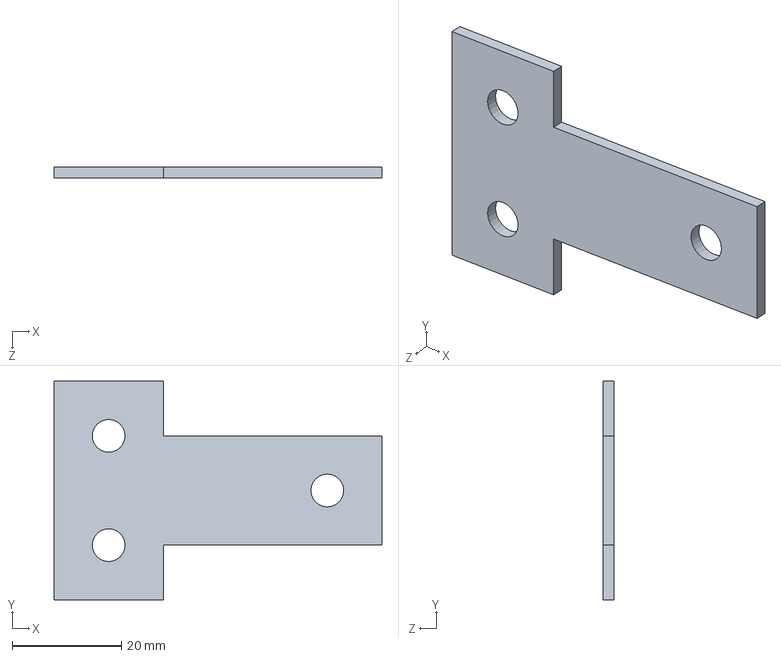
[picture p64: CAD file, 2020-08-15]
Assembling/TBracket.SLDPRT
60.0 x 40.0 x 2.00 mm
