maciejgaik/Inverted_pendulum/Assembling/Encoder tanso H40.SLDPRT

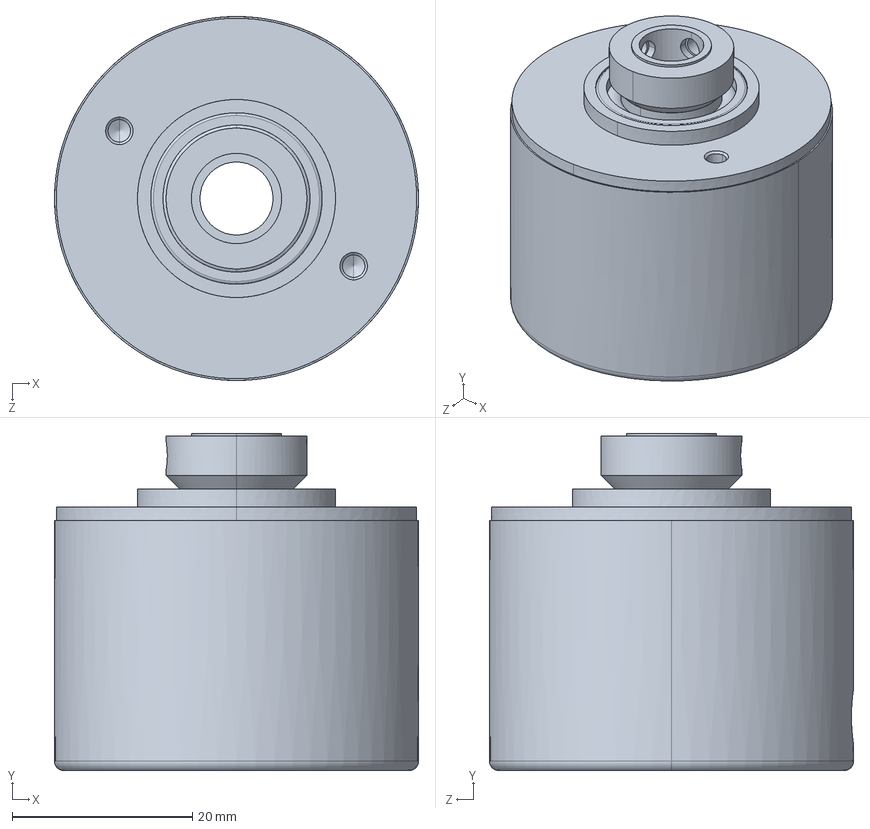
[picture p65: CAD file, 2020-08-15]
Assembling/Encoder tanso H40.SLDPRT
40.4 x 37.4 x 40.4 mm
