maciejgaik/Inverted_pendulum/Assembling/Gearmotor_37D_100.stp.SLDPRT

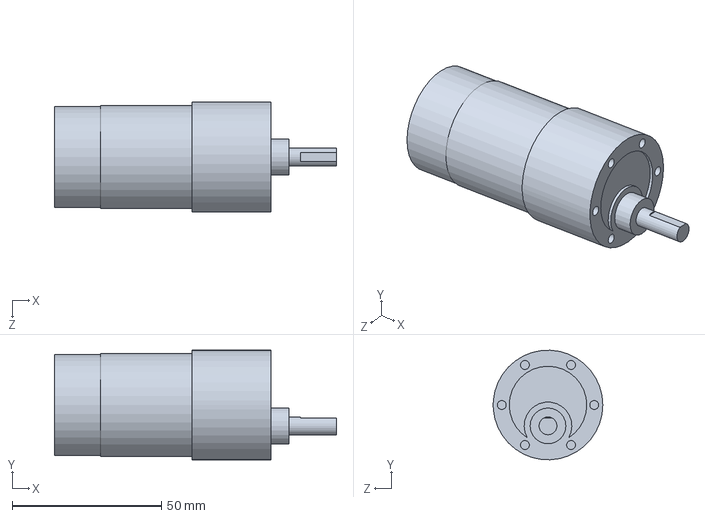
[picture p66: CAD file, 2020-08-15]
Assembling/Gearmotor_37D_100.stp.SLDPRT
94.6 x 36.8 x 36.8 mm
