maciejgaik/Inverted_pendulum/Assembling/GT2_48T_8_6.SLDPRT

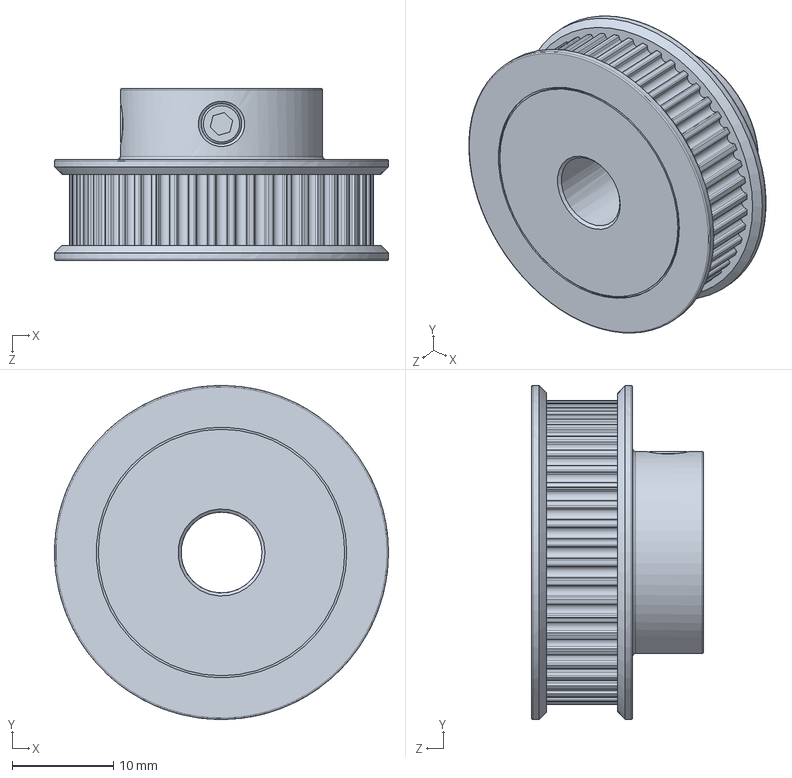
[picture p67: CAD file, 2020-08-15]
Assembling/GT2_48T_8_6.SLDPRT
33.0 x 33.0 x 17.0 mm
