maciejgaik/Inverted_pendulum/(list of files, cad)

Other CAD files:
Assembling/profil 2040 250.SLDPRT
Assembling/2x4_bracket.STL
Assembling/3x3 L Bracket.STL
Assembling/Encoder Bracket.STL
Assembling/krancowka.STL
Assembling/krancowka2.STL
Assembling/power supply bracket.STL
Assembling/power supply stand.STL
