maciejgaik/Inverted_pendulum/Software/inverted_pendulum/Core/Src/main.c

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
/* Includes ------------------------------------------------------------------*/
#include "main.h"

/* USER CODE BEGIN Includes */
#include "pid.h"
#include "stdio.h"
#include "string.h"
/* USER CODE END Includes */

/* USER CODE BEGIN PD */
#define PI 3.14159265358979323846
#define POSITION_RATIO 64.0*19.0/25.7/PI
#define MAX_CART_POS 433
#define CART_SIZE 32

/* USER CODE END PD */

TIM_HandleTypeDef htim1;
TIM_HandleTypeDef htim3;
TIM_HandleTypeDef htim4;
TIM_HandleTypeDef htim6;
TIM_HandleTypeDef htim10;
TIM_HandleTypeDef htim11;
TIM_HandleTypeDef htim13;
DMA_HandleTypeDef hdma_tim3_ch4_up;
DMA_HandleTypeDef hdma_tim4_ch1;

UART_HandleTypeDef huart2;
DMA_HandleTypeDef hdma_usart2_rx;
DMA_HandleTypeDef hdma_usart2_tx;

/* USER CODE BEGIN PV */

uint8_t START_POSITION_FLAG = 0;
uint8_t END_POSITION_FLAG = 0;
uint8_t START_BALANCING = 0;
uint8_t LED_FLAG = 0;
uint8_t MOTOR_FLAG = 0;
uint8_t FLAG_READY = 0;
uint8_t MOTOR_PID_FLAG = 0;
uint8_t PWM_FLAG = 0;
uint8_t ERROR_FLAG = 0;
uint8_t PENDULUM_PID_FLAG = 0;

volatile int16_t pendulum_pulse_count = 0;
double alpha = 0;

volatile int16_t motor_pulse_count = 0;
volatile int16_t cart_position = 0;

uint32_t timer_1 = 0;
uint32_t timer_2 = 0;

uint16_t motor_pwm_duty = 0;
uint16_t cart_dest = 0;
uint16_t size = 0;

cpid_t motor_pid;
cpid_t pendulum_pid;

volatile int16_t motor_pid_controll = 0;
volatile int16_t pendulum_pid_controll = 0;
volatile int16_t pid_controll = 0;

double filter = 0;

int16_t prev_speed = 0;

double wsp1 = 0.5;

char buf[70] = {0};

int32_t pData1 = 0;
int32_t pData2 = 0;

/* USER CODE END PV */

void SystemClock_Config(void);
static void MX_GPIO_Init(void);
static void MX_DMA_Init(void);
static void MX_TIM4_Init(void);
static void MX_TIM1_Init(void);
static void MX_TIM3_Init(void);
static void MX_TIM10_Init(void);
static void MX_TIM11_Init(void);
static void MX_TIM13_Init(void);
static void MX_USART2_UART_Init(void);
static void MX_TIM6_Init(void);
/* USER CODE BEGIN PFP */

/* Interrupts */
void HAL_GPIO_EXTI_Callback(uint16_t GPIO_Pin){
	if(GPIO_Pin == START_POS_Pin){
		START_POSITION_FLAG=1;
	}
	else if(GPIO_Pin == END_POS_Pin){
		END_POSITION_FLAG=1;
	}
	else if(GPIO_Pin == Button_Pin){
		START_BALANCING = 1;
	}
}

void HAL_TIM_PeriodElapsedCallback(TIM_HandleTypeDef *htim){
	if(htim==&htim10){
		LED_FLAG = 1;
	}
//	else if(htim==&htim11){
//		MOTOR_PID_FLAG = 1;
//	}
	else if(htim==&htim13){
		PWM_FLAG = 1;
		PENDULUM_PID_FLAG = 1;
		MOTOR_PID_FLAG = 1;
	}
//	else if(htim==&htim6){
//		PENDULUM_PID_FLAG = 1;
//	}
}

void parse(){
	char header[2];
	double _p=0.0, _i=0.0, _d=0.0, _x=0.0, _y=0.0, _z=0.0;
	sscanf(buf, "%s %lf %lf %lf %lf %lf %lf", &header, &_p, &_i, &_d, &_x, &_y, &_z);
	if(!strcmp(header, "P")){
		if(_p>=0.0 && _p<=50.0) pendulum_pid.p = _p;
		if(_i>=0.0 && _i<=50.0) pendulum_pid.i = _i;
		if(_d>=0.0 && _d<=50.0) pendulum_pid.d = _d;
		if(_x>=0.0 && _x<=50.0) motor_pid.p = _x;
		if(_y>=0.0 && _y<=50.0) motor_pid.d = _y;
		if(_y>=0.0 && _y<=10.0) wsp1 = _z;
	}
	else if(!strcmp(header, "S")){
		TIM3->CNT = 0;
	}
}

void HAL_UART_RxCpltCallback(UART_HandleTypeDef *huart){
	uint16_t size = 0;
	uint8_t data[100];
	parse();
	size = sprintf(data, "{\"mp\":%.2f,\"mi\":%.2f,\"md\":%.2f,\"pp\":%.2f,\"pd\":%.2f,\"wsp\":%.2f}", pendulum_pid.p, pendulum_pid.i, pendulum_pid.d, motor_pid.p, motor_pid.d, wsp1);
	HAL_UART_Transmit_IT(&huart2, data, size);
	HAL_UART_Receive_IT(&huart2, &buf, 37);
}

uint16_t ramp(uint16_t dest){
	int16_t ramp_duty = 0;
	//if(dest > 0 && dest < 27 ) dest = 27;
	if(dest/5 == motor_pwm_duty/5) return motor_pwm_duty;
	else{
		if(dest > motor_pwm_duty){
			ramp_duty=motor_pwm_duty+5;
			if(ramp_duty>=100) return 100;
			else return ramp_duty;
		}
		else{
			ramp_duty=motor_pwm_duty-5;
			if(ramp_duty<=0) return 0;
			else return ramp_duty;
		}
	}
}

void motor_speed(int16_t speed){
	if(speed * prev_speed < 0)
		motor_pwm_duty=ramp(0);
	else{
		if(speed < 0){
			if(cart_position > 5){
				if(cart_position > 30){
					HAL_GPIO_WritePin(MOTOR_IN1_GPIO_Port, MOTOR_IN1_Pin, GPIO_PIN_RESET);
					HAL_GPIO_WritePin(MOTOR_IN2_GPIO_Port, MOTOR_IN2_Pin, GPIO_PIN_SET);
					motor_pwm_duty=ramp(-speed);
				}
				else{
					HAL_GPIO_WritePin(MOTOR_IN1_GPIO_Port, MOTOR_IN1_Pin, GPIO_PIN_SET);
					HAL_GPIO_WritePin(MOTOR_IN2_GPIO_Port, MOTOR_IN2_Pin, GPIO_PIN_SET);
					motor_pwm_duty=100;
				}
			}
			else{
				HAL_GPIO_WritePin(MOTOR_IN1_GPIO_Port, MOTOR_IN1_Pin, GPIO_PIN_RESET);
				HAL_GPIO_WritePin(MOTOR_IN2_GPIO_Port, MOTOR_IN2_Pin, GPIO_PIN_RESET);
				motor_pwm_duty = 100;
			}
		}
		else if(speed > 0){
			if(cart_position < 428){
				if(cart_position < 400){
					HAL_GPIO_WritePin(MOTOR_IN1_GPIO_Port, MOTOR_IN1_Pin, GPIO_PIN_SET);
					HAL_GPIO_WritePin(MOTOR_IN2_GPIO_Port, MOTOR_IN2_Pin, GPIO_PIN_RESET);
					motor_pwm_duty=ramp(speed);
				}
				else{
					HAL_GPIO_WritePin(MOTOR_IN1_GPIO_Port, MOTOR_IN1_Pin, GPIO_PIN_SET);
					HAL_GPIO_WritePin(MOTOR_IN2_GPIO_Port, MOTOR_IN2_Pin, GPIO_PIN_SET);
					motor_pwm_duty=100;
				}
			}
			else{
				HAL_GPIO_WritePin(MOTOR_IN1_GPIO_Port, MOTOR_IN1_Pin, GPIO_PIN_RESET);
				HAL_GPIO_WritePin(MOTOR_IN2_GPIO_Port, MOTOR_IN2_Pin, GPIO_PIN_RESET);
				motor_pwm_duty = 100;
			}
		}
		else{
			motor_pwm_duty = ramp(0);
		}
	}
	prev_speed = speed;
}

void motor_stop(){
	HAL_GPIO_WritePin(MOTOR_IN1_GPIO_Port, MOTOR_IN1_Pin, GPIO_PIN_RESET);
	HAL_GPIO_WritePin(MOTOR_IN2_GPIO_Port, MOTOR_IN2_Pin, GPIO_PIN_RESET);
	motor_pwm_duty=0;
}

void motor_init(){
	HAL_GPIO_WritePin(MOTOR_IN1_GPIO_Port, MOTOR_IN1_Pin, GPIO_PIN_SET);
	HAL_GPIO_WritePin(MOTOR_IN2_GPIO_Port, MOTOR_IN2_Pin, GPIO_PIN_RESET);
	motor_pwm_duty=60;
	HAL_Delay(100);
	HAL_GPIO_WritePin(MOTOR_IN1_GPIO_Port, MOTOR_IN1_Pin, GPIO_PIN_RESET);
	HAL_GPIO_WritePin(MOTOR_IN2_GPIO_Port, MOTOR_IN2_Pin, GPIO_PIN_SET);
	motor_pwm_duty=35;
}


/* USER CODE END PFP */

/**
  * @brief  The application entry point.
  * @retval int
  */
int main(void)
{
  /* MCU Configuration--------------------------------------------------------*/

  /* Reset of all peripherals, Initializes the Flash interface and the Systick. */
  HAL_Init();

  /* Configure the system clock */
  SystemClock_Config();

  /* Initialize all configured peripherals */
  MX_GPIO_Init();
  MX_DMA_Init();
  MX_TIM4_Init();
  MX_TIM1_Init();
  MX_TIM3_Init();
  MX_TIM10_Init();
  MX_TIM11_Init();
  MX_TIM13_Init();
  MX_USART2_UART_Init();
  MX_TIM6_Init();
  /* USER CODE BEGIN 2 */

  HAL_TIM_Encoder_Start(&htim1, TIM_CHANNEL_ALL);
  HAL_TIM_Encoder_Start(&htim3, TIM_CHANNEL_ALL);
  //HAL_TIM_Encoder_Start_DMA(&htim3, TIM_CHANNEL_ALL, pData1, pData2, 2);

  HAL_TIM_Base_Start_IT(&htim10);
  HAL_TIM_Base_Start_IT(&htim11);
  HAL_TIM_Base_Start_IT(&htim13);
  HAL_TIM_Base_Start_IT(&htim6);

  HAL_TIM_PWM_Start_DMA(&htim4, TIM_CHANNEL_1, &motor_pwm_duty, 1);

  motor_init();

	pid_init(&motor_pid, 16.5, 0.0, 1.0, 1);
	motor_pid.p_max = 4095;
	motor_pid.p_min = -4095;
	motor_pid.i_max = 4095;
	motor_pid.i_min = -4095;
	motor_pid.d_max = 4095;
	motor_pid.d_min = -4095;
	motor_pid.total_max = 100;
	motor_pid.total_min = -100;


	pid_init(&pendulum_pid, 44.f, 10.0, 1.2f, 1);
	pendulum_pid.p_max = 4095;
	pendulum_pid.p_min = -4095;
	pendulum_pid.i_max = 4095;
	pendulum_pid.i_min = -4095;
	pendulum_pid.d_max = 4095;
	pendulum_pid.d_min = -4095;
	pendulum_pid.total_max = 100;
	pendulum_pid.total_min = -100;

	HAL_UART_Receive_IT(&huart2, buf, 37);


  /* USER CODE END 2 */

  /* Infinite loop */
  /* USER CODE BEGIN WHILE */
  while (1)
  {
	 // if(HAL_GetTick()<1000) cycle++;
    /* USER CODE END WHILE */

    /* USER CODE BEGIN 3 */

	  pendulum_pulse_count = TIM3->CNT;
	  alpha = 180-pendulum_pulse_count*360.0/1600.0;

	  motor_pulse_count = TIM1->CNT;
	  cart_position = -motor_pulse_count/64.0/19.0*25.7*PI;

	  if(LED_FLAG && !ERROR_FLAG){
		  HAL_GPIO_TogglePin(LED_B_GPIO_Port, LED_B_Pin);
		  LED_FLAG = 0;
	  }

	  if(LED_FLAG && ERROR_FLAG){
		  HAL_GPIO_WritePin(LED_B_GPIO_Port, LED_B_Pin, GPIO_PIN_RESET);
		  HAL_GPIO_TogglePin(LED_R_GPIO_Port, LED_R_Pin);
		  LED_FLAG = 0;
	  }

	  if(START_POSITION_FLAG && !FLAG_READY){
		  motor_stop();
		  TIM1->CNT=0;
		  START_POSITION_FLAG=0;
	  }

	  if(END_POSITION_FLAG && !FLAG_READY){
		  END_POSITION_FLAG=0;
	  }

	  if((START_POSITION_FLAG || END_POSITION_FLAG) && FLAG_READY){
		  motor_stop();
		  ERROR_FLAG = 1;
		  START_POSITION_FLAG=0;
		  END_POSITION_FLAG=0;
	  }

	  if(FLAG_READY){
		  if(PWM_FLAG){
			  PWM_FLAG=0;
			  pid_controll = pendulum_pid_controll-wsp1*motor_pid_controll;
			  motor_speed(pid_controll);
		  }
		  if(PENDULUM_PID_FLAG){
			  PENDULUM_PID_FLAG=0;
			  pendulum_pid_controll = -pid_calc(&pendulum_pid, pendulum_pulse_count, 800);
		  }
		  if(MOTOR_PID_FLAG){
			  motor_pid_controll = pid_calc(&motor_pid, cart_position, 215);
			  MOTOR_PID_FLAG=0;
		  }
	  }

	  if(START_BALANCING){

		  HAL_Delay(50);
		  if(!FLAG_READY){
			  FLAG_READY=1;
		  }
		  else{
			  FLAG_READY=0;
			  motor_stop();
		  }
		  START_BALANCING=0;
	  }
  }
  /* USER CODE END 3 */
}

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
