maciejgaik/Inverted_pendulum/Software/inverted_pendulum/inverted_pendulum.ioc

Mcu.UserName=STM32F407VGTx
PA0-WKUP.GPIO_Label=Button
PA0-WKUP.Signal=GPXTI0
PA2.Signal=USART2_TX
PA3.Signal=USART2_RX
PA6.Signal=S_TIM3_CH1
PA7.Signal=S_TIM3_CH2
PB4.GPIO_Label=MOTOR_IN2
PB4.Signal=GPIO_Output
PB5.GPIO_Label=MOTOR_IN1
PB5.Signal=GPIO_Output
PB6.GPIO_Label=MOTOR_PWM
PB6.Signal=S_TIM4_CH1
PC7.GPIO_Label=START_POS
PC7.Signal=GPXTI7
PC9.GPIO_Label=END_POS
PC9.Signal=GPXTI9
PD12.GPIO_Label=LED_G
PD12.Signal=GPIO_Output
PD13.GPIO_Label=LED_O
PD13.Signal=GPIO_Output
PD14.GPIO_Label=LED_R
PD14.Signal=GPIO_Output
PD15.GPIO_Label=LED_B
PD15.Signal=GPIO_Output
PE11.Signal=S_TIM1_CH2
PE9.Signal=S_TIM1_CH1
PH0-OSC_IN.Signal=RCC_OSC_IN
PH1-OSC_OUT.Signal=RCC_OSC_OUT
