maciejgaik/Inverted_pendulum/(commit log)

2020-08-13 Edit CAD model
2020-08-15 Add Solidworks files
    [Encoder tanso H40.SLDPRT, GT2_48T_8_6 idle.SLDPRT, GT2_48T_8_6.SLDPRT, Gearmotor_37D_100.stp.SLDPRT, Kit CGV02-05 + EEV01-01 + RWV01-01.SLDPRT, Pololu Stamped Aluminum L-Bracket Pair for 37D mm Metal Gearmotors.SLDPRT, TBracket.SLDPRT, Złożenie3.SLDASM]
2020-08-19 Add LBracket 3x3 and upgrade pololu bracket
    [3x3 L Bracket.SLDPRT, 3x3 L Bracket.STL, Pololu Stamped Aluminum L-Bracket Pair for 37D mm Metal Gearmotors.SLDPRT, pololu bracket.STL]
2020-08-21 Add Encoder Bracket
    [Encoder Bracket.SLDPRT, Encoder Bracket.STL, Kit CGV02-05 + EEV01-01 + RWV01-01.SLDPRT, Złożenie3.SLDASM]
2020-08-21 Edit Pololu bracket
    [Pololu Stamped Aluminum L-Bracket Pair for 37D mm Metal Gearmotors.SLDPRT, pololu bracket.STL]
2020-08-26 Add STM32CUBE project
2020-08-27 Add some new brackets
    [Encoder Bracket.SLDPRT, Encoder Bracket.STL, Pololu Stamped Aluminum L-Bracket Pair for 37D mm Metal Gearmotors.SLDPRT, pololu bracket.STL, power supply bracket.SLDPRT, power supply bracket.STL, power supply stand.SLDPRT, power supply stand.STL]
2020-08-27 Reading encoders value
2020-08-29 Create stm bracket.STL
    [stm bracket.STL]
2020-09-01 Add endstop bracket
    [krancowka.SLDPRT, krancowka.STL, krancowka2.SLDPRT, krancowka2.STL]
2020-09-01 Add some motor functionn
    Add motor_init, motor_stop, motor_go_to etc.
2020-09-01 Add PID controller files
2020-09-09 Add test alfa-beta filter
2020-09-10 Edit alfa-beta filter
2020-09-15 Add test ramp pwm
2020-10-05 First stable version
    The pendulum oscillates arounnd the up position
    [inverted_pendulum.ioc, main.c]
2020-10-25 Revert "New commit"
    This reverts commit 6c4d62871c500af76855fc580bf81489cce219b2.
    [inverted_pendulum.ioc, main.c]
2020-10-25 Revert "First stable version"
    This reverts commit 1ca43a4be21fc74d14164c4f8d2712094522c4c2.
    [inverted_pendulum.ioc, main.c]
2020-11-22 Edit double PID
2020-11-29 Some edits
    Deleted alfa-beta
    Edited PID
    Frequency 1kHz
